vingarzan/vw-touareg-760-867-899-tailgate-clip/README.md

# VW Touareg tailgate clip — 760 867 899

**Latest flat-backed models: [v30 shorter lip and full-height rear supports, both fin layouts](drafts/v30/README.md).** Root `stl/` files remain the older v17 baseline.

Printable reconstruction from photographs and caliper measurements of the original clip.

**Status: v17 moves the small retaining clip 2 mm farther from the peg and extends the mounting base by 4 mm in the same direction. Peg, fin and hook stations are retained. Both versions remain in design coordinates. Physical fit remains untested.**

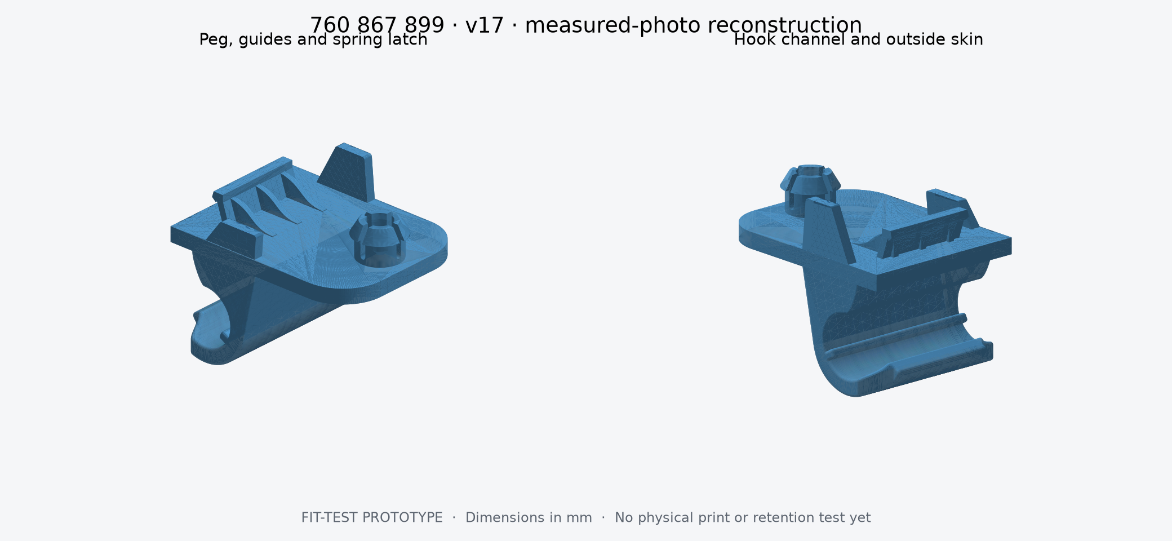
[picture p1: previews/clip.png]
Model preview


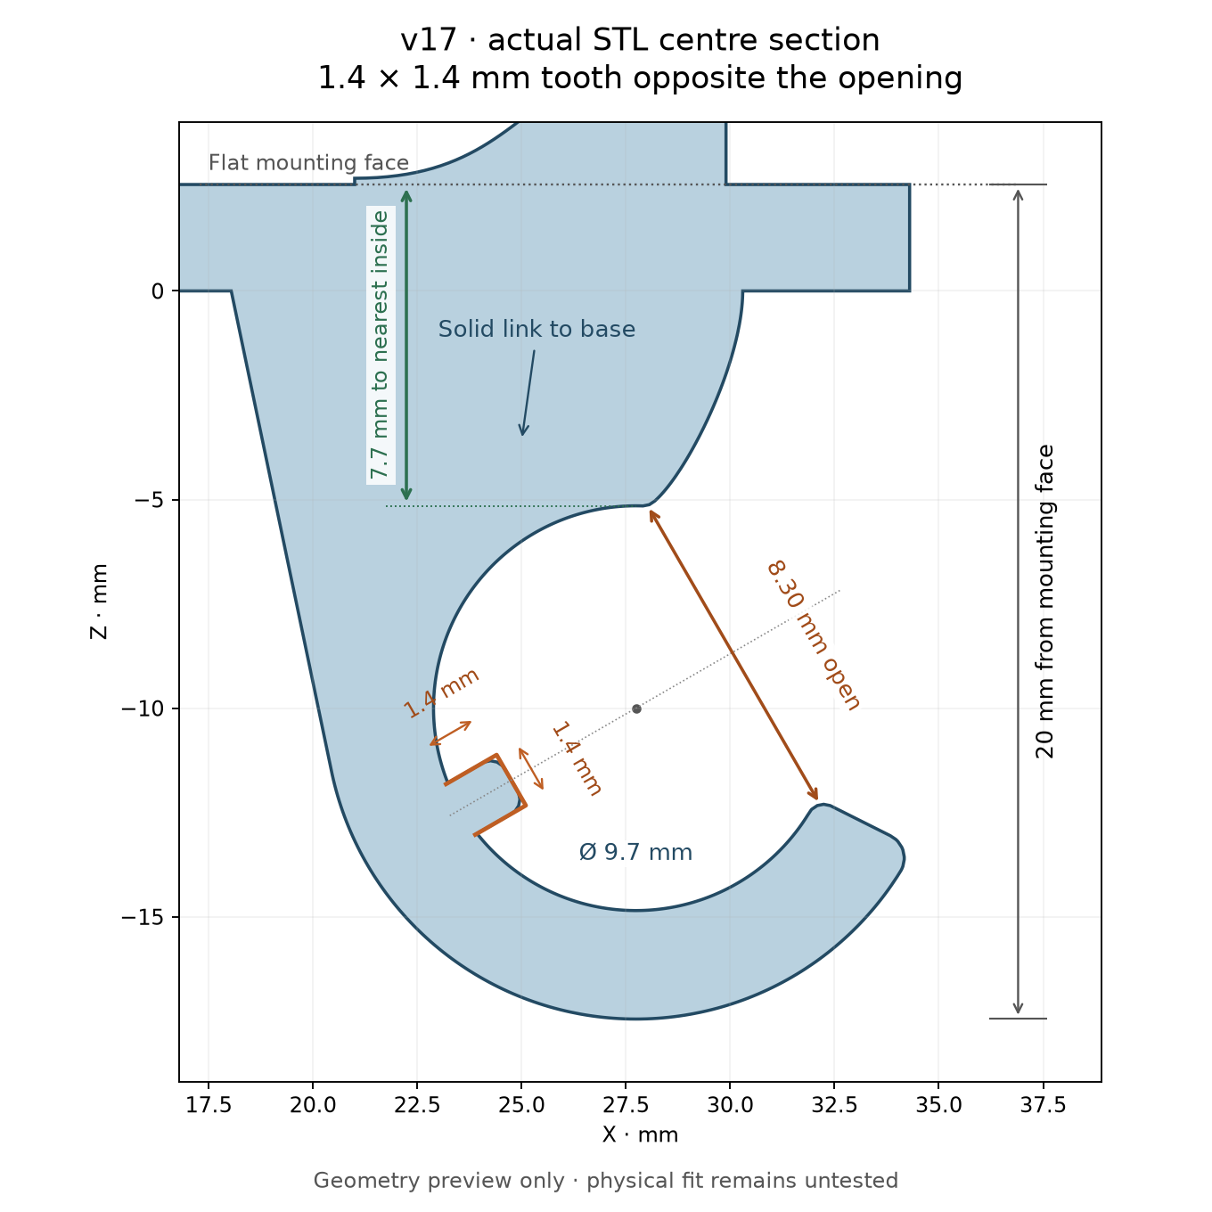
[picture p2: previews/hook_section.png]
Section of the actual STL showing the hook opening and rib


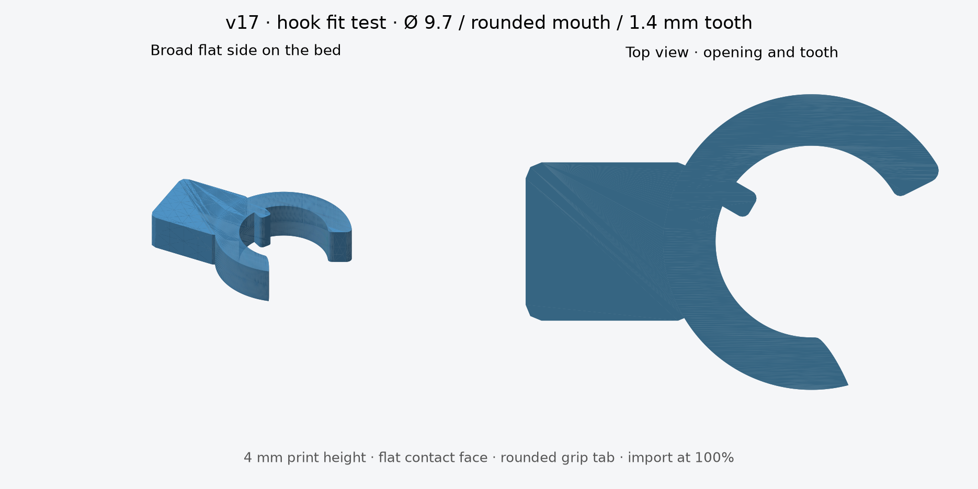
[picture p3: previews/hook_fit_test.png]
Side-printable hook fit test


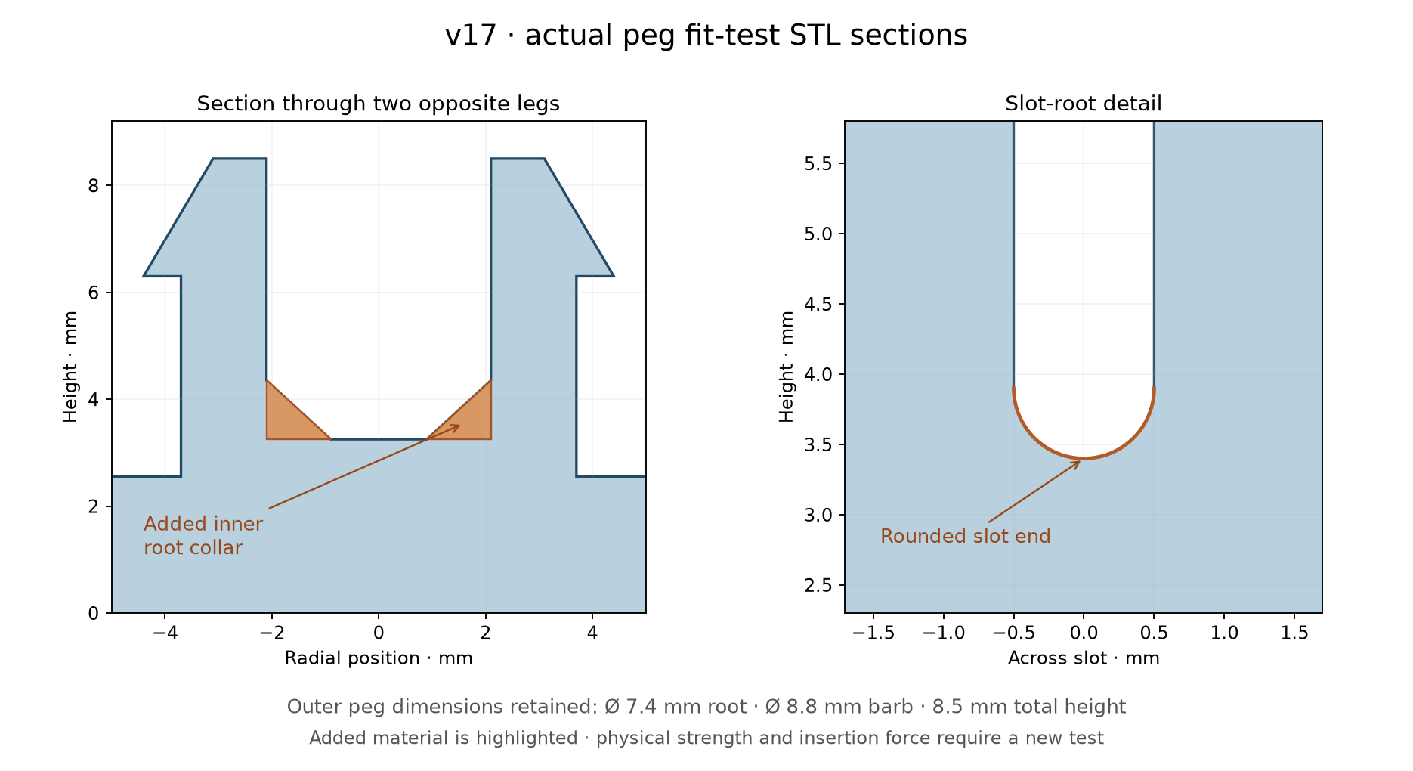
[picture p4: previews/peg_reinforcement.png]
Peg root reinforcement and rounded slot ends


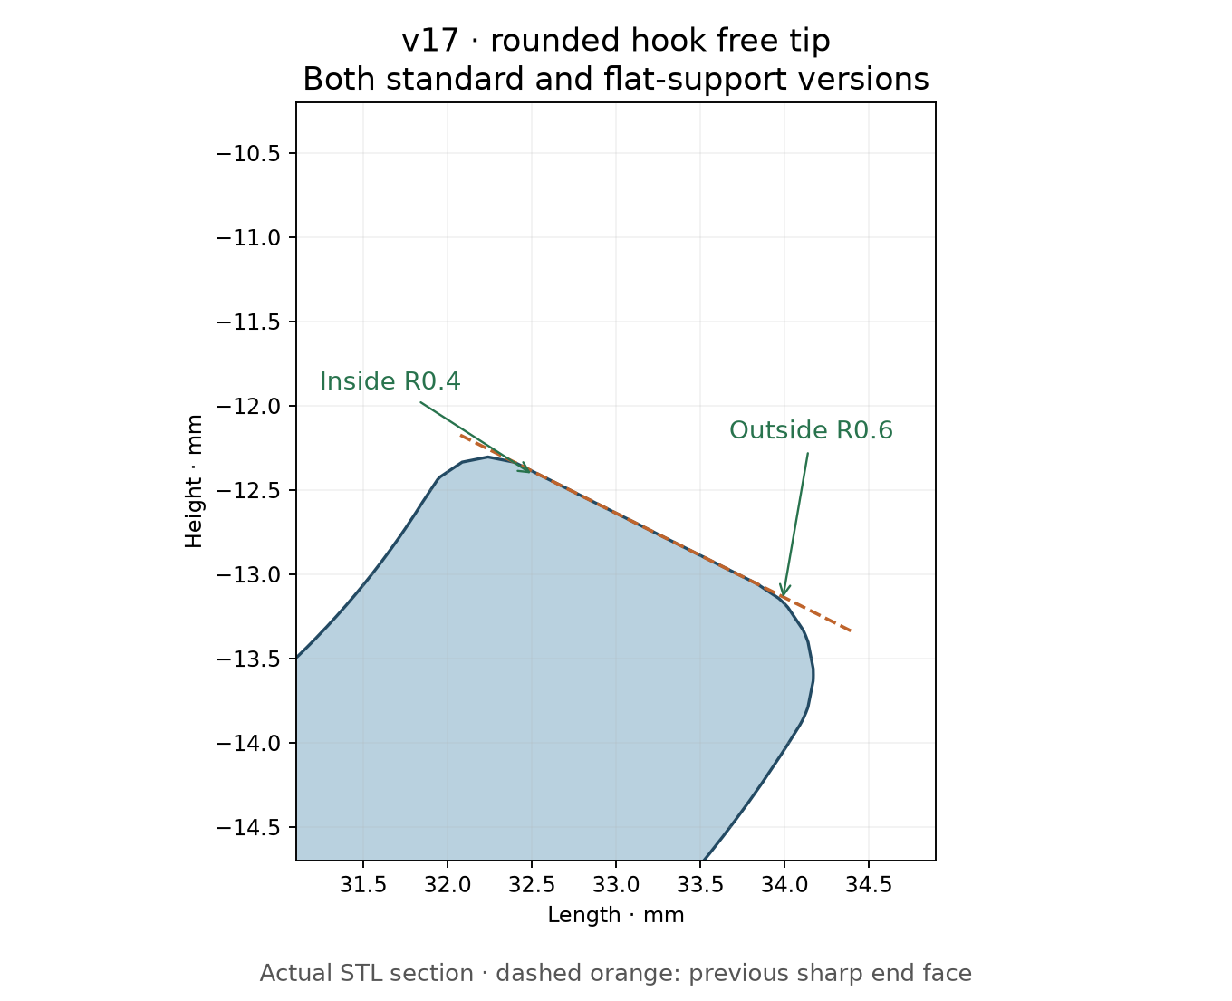
[picture p5: previews/rounded_tip.png]
Rounded free hook tip


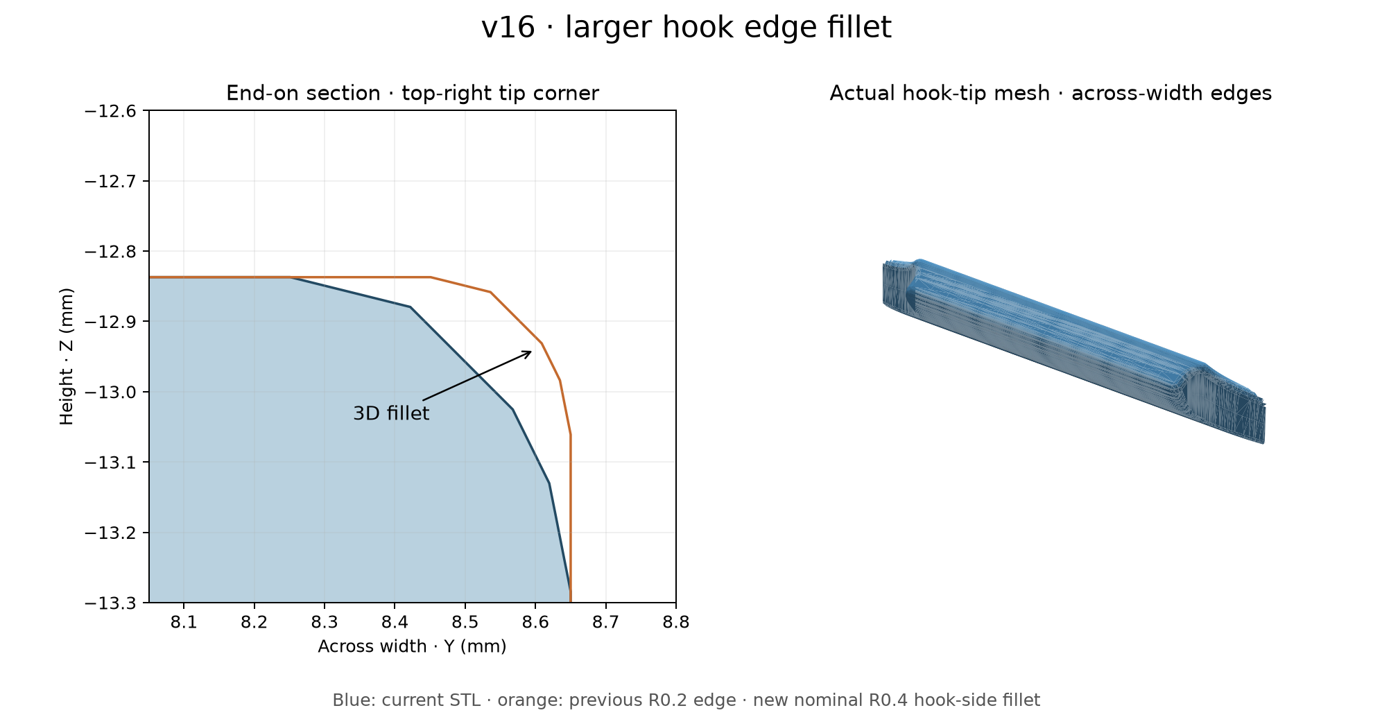
[picture p6: previews/hook_3d_edges.png]
Actual end-on section showing rounding across the width


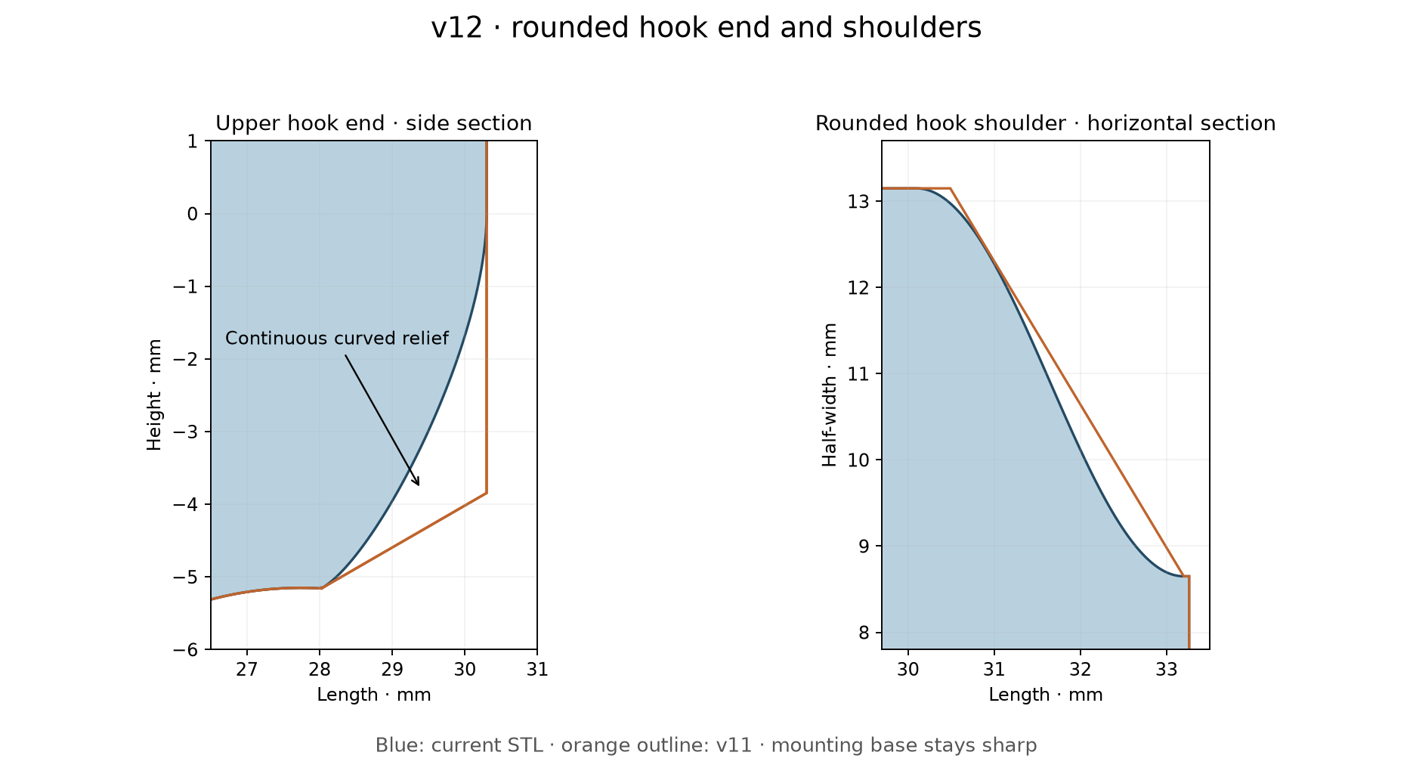
[picture p7: previews/rounded_hook.png]
Rounded hook upper end and shoulders


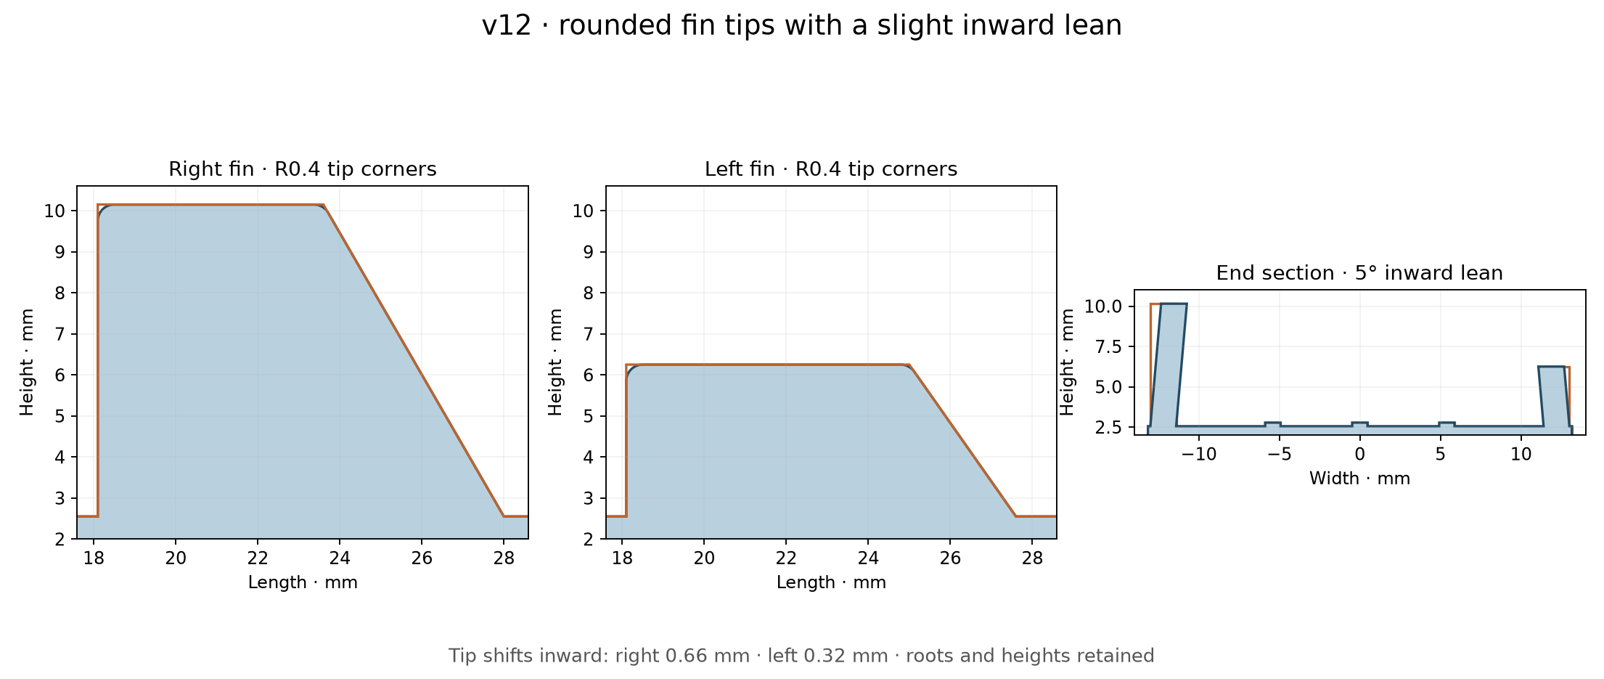
[picture p8: previews/rounded_fins.png]
Rounded fin tips and inward lean


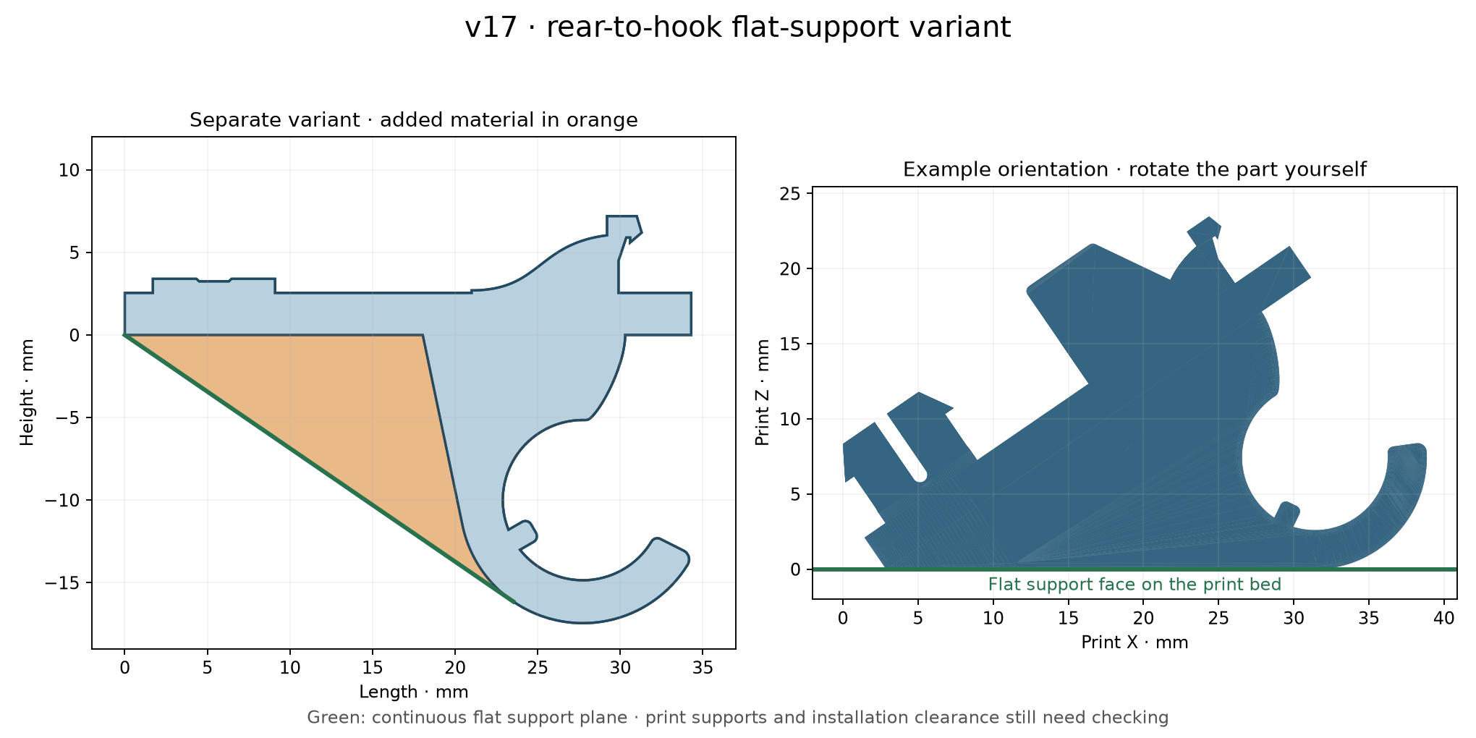
[picture p9: previews/flat_support_profile.png]
Separate flat-support variant and print orientation


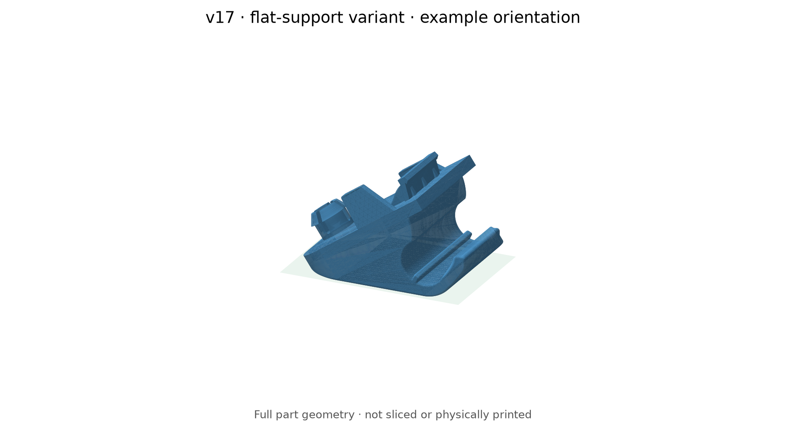
[picture p10: previews/flat_support_print.png]
Example flat-support orientation


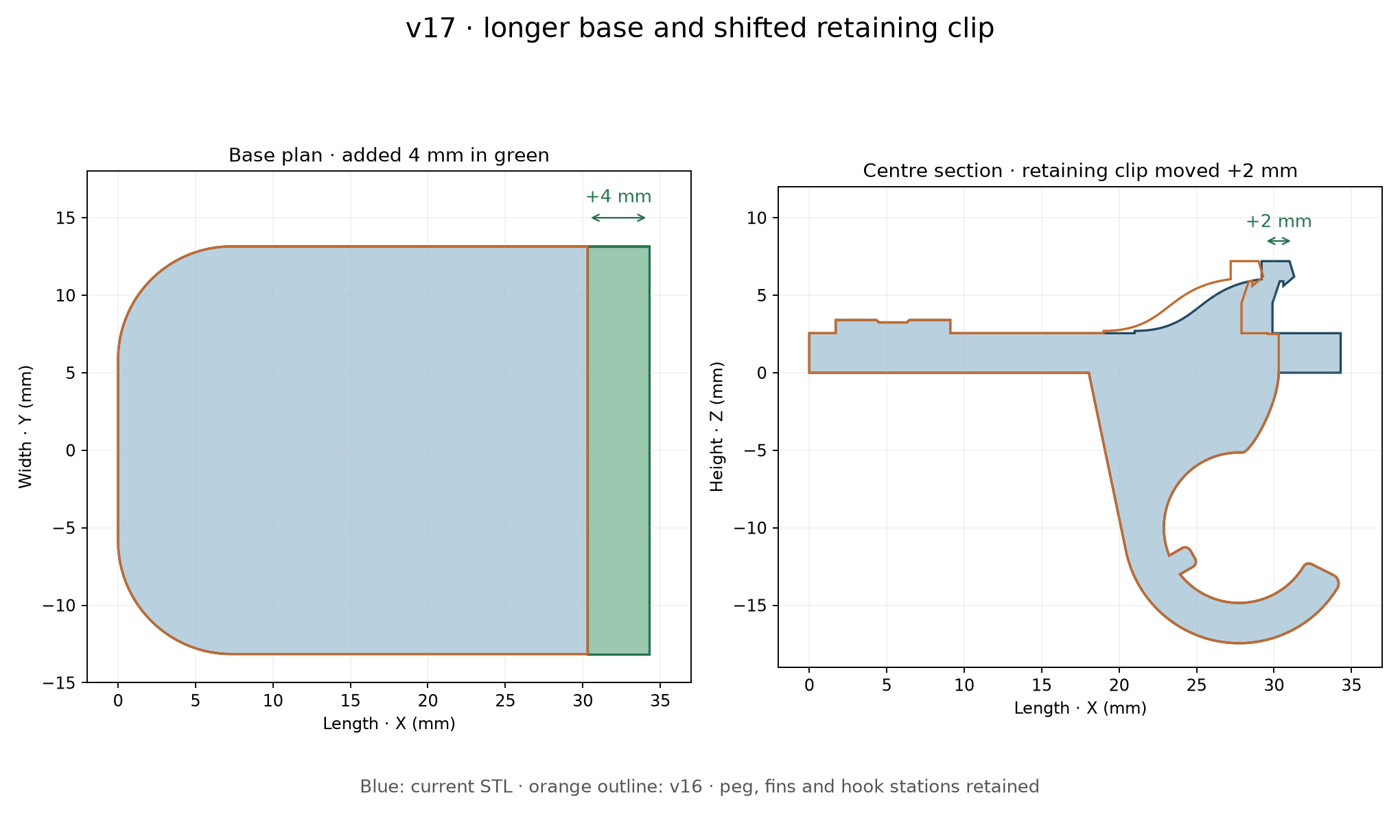
[picture p11: previews/layout_change.png]
Base extension and retaining-clip shift


## STL files

All files use millimetres. Import at 100% scale.

- [`stl/760867899_clip_flat_support.stl`](stl/760867899_clip_flat_support.stl): separate variant with a continuous flat rear support face from the rear underside of the base, tangent to the outside hook curve.
- [`stl/760867899_clip.stl`](stl/760867899_clip.stl): complete clip in design coordinates.
- [`stl/760867899_hook_fit_test.stl`](stl/760867899_hook_fit_test.stl): a compact **side-printable hook gauge** with a rounded grip tab. It has the actual 9.7 mm bore, rounded entrance (about 8.30 mm at the reference throat station) and 1.4 × 1.4 mm tooth, without the bulky mounting body. It is already laid on its broad flat side and is only **4 mm high**. Import at 100%, keep this orientation and print without supports. It checks the mating shape, not full-width stiffness or retention.
- [`stl/760867899_peg_fit_test.stl`](stl/760867899_peg_fit_test.stl): the reinforced split peg on a 14 × 14 mm flat base. Print this updated test with the peg upright to check the new root support and fitting force before printing the complete clip.

The full clips are supplied in design coordinates. Rotate them in your slicer.
The pre-rotated full-part STLs were removed in v14; earlier versions remain in
Git history. The compact hook gauge still uses its natural broad-side orientation.
The complete part has undercuts.
It has not been sliced or printed. Keep support material out of the four peg
slots and the spring latch where possible; inspect and clear those gaps before
attempting a fit. Do not force an undersized hook or oversized peg into the car.

## Validation and rebuilding

The exported STLs were reloaded and checked for a single connected solid,
watertightness, consistent winding, positive volume and no zero-area triangles.
Float32-collapsed triangles are removed before export; valid small-area fillet
triangles are retained. The report records the minimum triangle area.
See [`validation/geometry_checks.json`](validation/geometry_checks.json).
Cross-sections of the exported clip also independently verify the rounded-tip arcs,
minimum nominal opening clearance and actual local entry width,
peg diameters and height, both fins, the 9 mm longitudinal edge gap, lip width
and latch width to 0.003 mm of their design values. The 8.1 mm
sharp-lip throat is a nominal reference; the rounded local entry is approximately 8.30 mm. That is a digital geometry tolerance, not a physical measurement
or printing accuracy claim.
The checks also measure the 20 mm hook drop and the 1.4 × 1.4 mm projecting tooth
at both ends and the centre. Fifty-one rays through the exported STL's entry
path check that the mouth is not blocked by the platform, frame or neck.
Twenty additional sections across the back link verify one continuous material
interval at the former gap, including the centre and both sides.
The hook gauge has separate exported-STL checks: full first-layer contact, a
constant profile through its 4 mm print height, matching mating geometry against
the complete clip, and measured bore, mouth and tooth at three width stations.
The external grip tab does not intrude into the cavity or entry. Its footprint
is approximately 20.92 × 14.75 mm.
Three sections through the front crossbar and the overall model width verify
that its lateral edges are flush with the 26.3 mm base.
Additional exported sections check the flush side width, tangent backing and
lower circular exterior, eight diagonal sections of the peg collar, and ten
points along its rounded slot ends. These are geometry checks, not evidence of
physical strength, printed fit or service life.

The across-width close-up is generated with `python model/render_3d_edges.py old.stl`.

Hook and fin close-ups are generated with `python model/render_rounding.py old.stl`
using an exported previous clip for the orange outline.

The before/after base preview is generated from exported STL sections with
`python model/render_base_sides.py old.stl new.stl preview.png`.

The rebuildable source is provided to preserve the design history even though
only STLs are needed for printing:

```sh
python3 -m venv .venv
.venv/bin/pip install -r model/requirements.txt
.venv/bin/python model/build.py
```

[`model/parameters.json`](model/parameters.json) separates measured dimensions
from estimates. The standard model retains the measured fin root positions and heights and
places their nearest root edges **9 mm beyond the hook-facing edge of the
peg root along the length of the base**. This is an approximate physical
measurement implemented as 9.0 mm in the model.

The back of the hook now joins the mounting base through a **solid full-width
web**, filling the triangular gap left in v05. The original rear slope is kept;
only the hook cavity and entry remain open. This is a geometry change requested
by the owner, rather than a reproduction of the OEM material-saving recess.

The new caliper photo measures **7.7 mm from the peg/fin mounting face to the nearest inside hook curve**, perpendicular to that face. This was 7.8 mm in v09. Preserving the 20 mm outside drop and 9.7 mm bore gives a derived hook wall of **2.6 mm** (20 − 7.7 − 9.7), replacing the estimated 2.5 mm. This is not the distance to the lower free lip.

The separate lateral support webs have been removed. The hook, back link and
neck now stay within the **26.3 mm base width**, with no support projecting
past the base below the mounting plane. The solid back link meets the outer
hook circle at a tangent, eliminating the stepped middle/lower support corners.
In v11 the **front crossbar is also trimmed to 26.3 mm**, removing its remaining
0.65 mm tab on each side. The original 27.6 mm width is retained in the measurement
record as reference; the printable model now has a maximum width of 26.3 mm.

The peg now includes an **internal tapered root collar**. At the cavity floor
(Z=3.25 mm), the inner radius is reduced from 2.1 to 0.9 mm; it tapers back to
2.1 mm over 1.1 mm of height. This adds material inside each leg at its root
while retaining the upper hollow section. The 1 mm-wide slots now terminate in
0.5 mm-radius semicircles, with their lowest cut at Z=3.4 mm instead of the old
sharp Z=3.25 mm corners. Outer diameters and total peg height are retained.
These are new design choices intended to reinforce the roots; insertion force,
flexibility, strength and fatigue must be checked with a fresh physical trial.

The opposite 15 mm-wide latch now joins the base through a continuous wall,
reinforced by three solid gussets on the peg side. Its wall thickness and lean
are photo estimates. The mounting surface beneath peg and fins is flat and
continuous, as requested by the owner; material-saving recesses are omitted.

Looking from the **rounded peg end toward the hook**, with the peg pointing up,
the **right fin is the taller fin** (negative Y). In their side profiles, both
fins retain a straight peg-facing edge below the rounded tip and taper toward
the hook. The upper profile corners now have **R0.4 mm** rounding. The measured
top lengths are kept as the unrounded construction envelope; rounding shortens
the flat part at the very top. Both fins lean **5° inward across the width**,
shifting their ends inward by 0.66 mm (right) and 0.32 mm (left). Root positions,
1.6 mm wall thickness and heights are retained. The fin rounding and lean values are
design choices. Please compare with the original before printing the whole part.

## Flat-support variant

The optional version adds a solid wedge under the base, extending the existing
hook backing to the rounded rear of the base. Its outside face is a single
plane tangent to the hook circle. In the example flat-face-down orientation,
it has approximately **699 mm² of bed contact**, and every vertex is above that
plane. No rotated full-part STL is supplied. This is a
geometry check, not a sliced or printed support-free claim. The peg, fins,
retaining latch and measured hook mating dimensions are retained. The extra
backing adds approximately **3.43 cm³** of material; its installation clearance
needs checking. Both standard and flat-support versions include the v14 rounded
free tip. See [`validation/flat_support_checks.json`](validation/flat_support_checks.json)
for the exported mesh, contact-plane and mating-section checks.

## Reference measurements

| Feature | mm | Evidence |
|---|---:|---|
| Overall length | 34.4 | `reference/measurements/01.jpg` |
| Body width at first measurement position | 26.3 | `reference/measurements/02.jpg` |
| Earlier caliper span; not used as total height | 19.8 | `reference/measurements/03.jpg`; superseded height interpretation |
| Hook inside diameter | 9.7 | Owner correction explicitly confirmed as diameter; supersedes the initial 9.4 mm reading in photo 08 |
| Mounting face to nearest inside hook curve | 7.7 | `reference/measurements/20.jpg`; perpendicular to mounting face |
| Hook mouth, narrower entrance | about 8–8.2; model 8.1 | `reference/measurements/09.jpg` and owner clarification |
| Mounting face down to farthest outside hook edge, perpendicular | 20 | Owner measurement and explicit direction clarification |
| Internal tooth local height / inward projection | 1.4 / 1.4 | Owner corrected the earlier 2.4 mm values and specified placement opposite the opening |
| Narrow hook lip width | 17.3 | `reference/measurements/10.jpg`; read from jaw placement |
| Original maximum frame width; trimmed to 26.3 in v11 | 27.6 | `reference/measurements/11.jpg` |
| Outside guide width | 26.0 | `reference/measurements/12.jpg` and owner clarification |
| Base wall | 2.5–2.6 | Owner measurement; design uses midpoint 2.55 |
| Peg total height, including base wall | 8.5 | Owner measurement |
| Peg widest diameter / base diameter | 8.8 / 7.4 | Owner measurement |
| Spring latch width | 15.0 | Owner measurement |
| Right fin: base / top length | 9.9 / 5.5 | Owner measurement |
| Right fin: height above inner surface | 7.6 | Owner measurement and explicit height clarification |
| Left fin: base / top length | 9.5 / 6.9 | Owner measurement |
| Left fin: height above inner surface | 3.7 | Owner measurement |
| Both fin walls | 1.6 | Owner measurement |
| Peg root to nearest fin edges, along base length | about 9 | Owner measurement; edge-to-edge direction explicitly confirmed |

The peg position, hollow centre and slits, latch positions, flexure thicknesses,
and small radii are photo estimates. Photographs do not provide a calibrated 3D scan.

The mounting face is Z=2.55 mm. The corrected hook drop puts its lowest outside
edge at Z=-17.45 mm. The right fin reaches Z=10.15 mm, making the complete model
**approximately 34.3 × 26.3 × 27.6 mm** in v17: the extended base now determines
the overall length. The 34.4 mm OEM sharp-tip envelope is retained as a historical
reference for locating the hook; the hook itself was not moved. v01–v03 incorrectly treated the earlier 19.8 mm caliper
span as the entire part height; v04 supersedes that interpretation.

The hook/support body now receives a **nominal R0.4 mm 3D fillet** on its
exposed convex edges, including the across-width edges that remained sharp in
v14. This uses a tessellated rolling-ball edge treatment. The mounting plate
at and above its underside plane, plus the peg, fins and retaining clip, are
restored unchanged; no extra fillets are applied to those features.
An end-on exported-STL section verifies relief on both lateral tip corners.
v16 doubles the 3D edge radius from 0.2 to 0.4 mm and increases the inner
free-tip radius from 0.25 to 0.4 mm. The outer tip remains R0.6 mm.
The extra edge treatment increases the local reference-station opening to
approximately 8.30 mm. The 9.7 mm bore and mounting datums remain unchanged.
The above-plate geometry in v16 was compared against v15;
see [`validation/v16_preserved_features.json`](validation/v16_preserved_features.json).

The free hook tip has tangent **R0.6 mm outside** and **R0.4 mm inside** corners,
removing both sharp cap edges. Rounding shortens the overall sharp-tip envelope
by about 0.23 mm and widens the local entrance from the 8.1 mm reference to about
8.20 mm. The 9.7 mm bore, tooth and mounting distances are retained.

The hook upper end now uses a smooth curved relief in place of the former
angled flat face. Its lateral shoulders use a smooth taper rather than straight
diagonal cuts. In v12, the mounting base, peg and retaining latch were compared with v11
and have zero geometric difference in their checked regions; see
[`validation/v12_preserved_features.json`](validation/v12_preserved_features.json).
The updated hook gauge reproduces the new central upper-end profile.

The mouth points diagonally outward, as shown in the new side photo, rather
than upward into the mounting platform. Its direction is estimated at 30°
above the base's length axis. The 9.7 mm circular cavity and an 8.1 mm-wide
entry corridor are cleared from the plate/frame/neck geometry; the C-shaped
hook supplies the mating surface. The upper fixed arm stays attached to the
mounting platform, while the entry remains open.

The internal feature is a solid transverse **rib**, not a recessed groove.
It projects 1.4 mm radially inward from the nominal inner wall and measures
1.4 mm along the local tangent of the bore. Its centreline is diametrically
opposite the mouth centreline, as specified by the owner, and it runs across
the part width. The section preview shows the shared diameter as a dotted line.
Its small edge radii remain estimates. The hook's 2.6 mm radial shell thickness
is derived from the 20 mm outside drop, 7.7 mm nearest-inside distance and
9.7 mm bore. The mounting base independently uses 2.55 mm thickness.

The peg centre remains an estimate at X=5.4 mm from the rounded end. Its root
ends at X=9.1 mm; the fins start at X=18.1 mm. The flat platform extends to
X=34.3 mm in v17, compared with the v16 base/crossbar end at X=30.3 mm.
This is a **4 mm increase in actual mounting-base length**. The small retaining
clip, its wall and all three ribs are translated **2 mm along +X**, away from
the peg. The 15 mm clip width and its shape are retained; the peg, fins and hook
locations are unchanged. See [`validation/v17_layout_checks.json`](validation/v17_layout_checks.json).
Only the relative peg-to-fin station has now been measured. The latch station,
its approximately 1.2 mm-thick support wall and the front frame position remain
photo estimates and should be compared with the original before printing.

## First print

1. Print the hook and peg fit-test pieces at 100% scale. The peg piece sits flat
   with the peg upright. Keep the hook gauge on its broad flat side as supplied:
   it is 4 mm high with approximately 130 mm² of bed contact. No supports are
   needed for its constant profile. Use the rounded external tab to hold it.
   The complete clip still requires separate inspection of support placement.
2. Compare the full clip preview with the original, especially the tall-fin side.
3. Inspect support placement and layer paths for the full clip. The side STL is
   an orientation option, not a validated print profile. Its small contact area
   may need a brim, and its horizontal peg and fins may need support.
4. Check fit gently, then inspect for cracking and adequate retention before
   using it to hold tailgate trim. A fit-test pass does not establish service life.

Printer, material, shrinkage, temperature resistance and spring fatigue have not
been validated. No material-specific printer settings are supplied.

## Revision policy

Commit every model revision with its STL files, source parameters, preview, checks,
and change notes. Keep stable filenames for the current files; Git history retains
all prior revisions. Do not squash or overwrite the design history.

## Photographs

- `reference/measurements/`: twenty owner-provided JPEG references, in received
  order, published with the owner's explicit permission. Camera metadata was
  removed before inclusion. Photos 13 and 14 show the same measurement view;
  photos 15–18 show the latch wall and its reinforcement in close-up; photo 19
  shows the hook's open side profile and projecting internal rib; photo 20
  records the 7.7 mm base-to-nearest-inside measurement used in v10.
- `reference/listing/source.txt`: the public product listing and original photo
  links, for provenance only. The seller's photographs are **not redistributed**
  in this repository, including in its published Git history.

VW and Touareg identify the part reference only. This project is not an OEM CAD
release or a certified replacement.
