vingarzan/vw-touareg-760-867-899-tailgate-clip/drafts/v19/README.md

# v19 fast draft — fin roots moved inward

Millimetres; import at 100% scale. Fin root outside-to-outside span is 24.5 mm, reduced from 26.0 mm. This moves each fin 0.75 mm inward. The explicit 24.5 mm measurement is used in preference to the approximate 0.5 mm movement request. Clear inside gap is approximately 21.3 mm with the retained 1.6 mm walls.

Includes the measured taper profiles, longer base, +2 mm retaining-clip shift, swept support and shallow rounded-profile recesses. Expensive final 3D support fillets and recess-floor rounding remain omitted from this draft. The fin heights, tip shape and inward lean are unchanged.

The exported STL is watertight, consistently wound and has positive volume. Physical fit and full dimensional validation are not established. Generate with build(edge_round=False, quick_draft=True). The main published model remains v17 pending completion of these draft revisions.

The flat-backed version is also available as stl/760867899_clip_flat_support.stl, in design coordinates. It uses the same latest tapered profiles and 24.5 mm fin root span. Its continuous rear-to-hook flat backing is retained. Basic mesh checks pass; the same unfinished edge-treatment caveat applies. Generate with build(flat_support=True, edge_round=False, quick_draft=True).
