vingarzan/vw-touareg-760-867-899-tailgate-clip/drafts/v18/README.md

# v18 work-in-progress draft

Exported at the owner’s request before final edge treatment. This STL includes the approved measured tapers, 34.3 mm base, +2 mm retaining-clip shift, revised swept support, and shallow rounded-profile side recesses. The final 3D edge fillets and recess-floor fillets are omitted.

Millimetres; import at 100% scale and choose orientation yourself. Basic reload checks confirm watertightness, consistent winding and positive volume. Full dimensional validation, physical fit and printing are not established.

The model folder is a snapshot of the working source. Generate this draft with build(edge_round=False, quick_draft=True), rather than the unfinished full-fillet build. The main published model remains v17 until v18 is completed.
