vingarzan/vw-touareg-760-867-899-tailgate-clip/previews/flush_base_sides.png

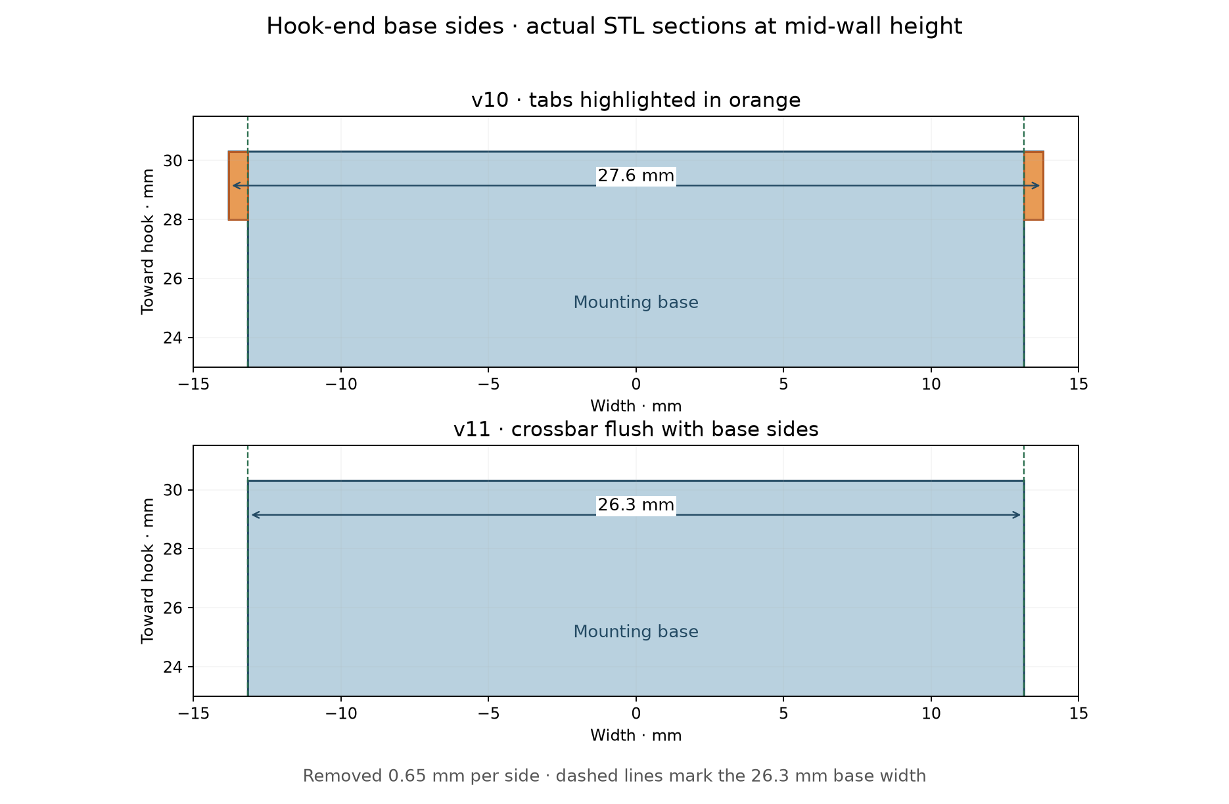
previews/flush_base_sides.png
