vingarzan/vw-touareg-760-867-899-tailgate-clip/previews/orthographic.png

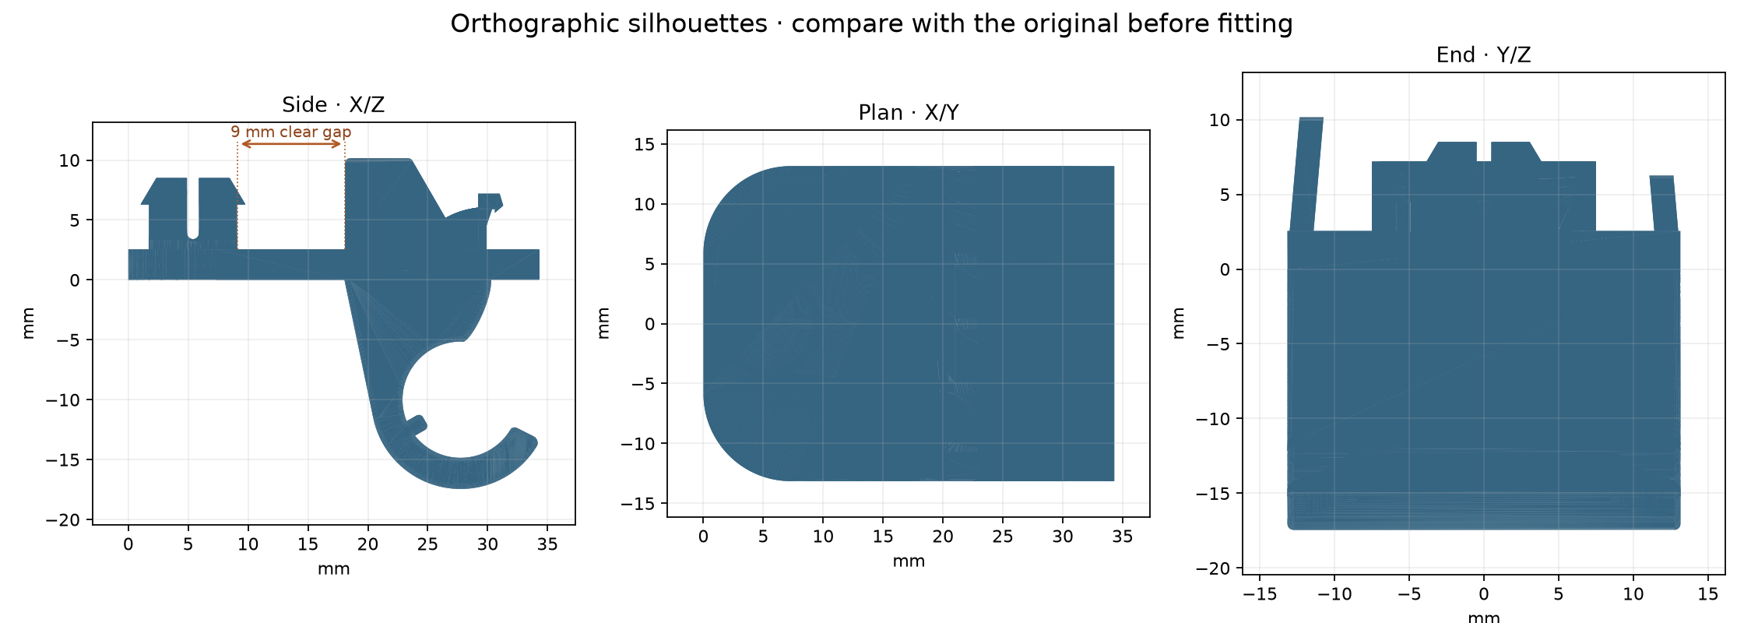
previews/orthographic.png
