vingarzan/vw-touareg-760-867-899-tailgate-clip/drafts/v30/stl/760867899_v30_existing_flat_support.stl

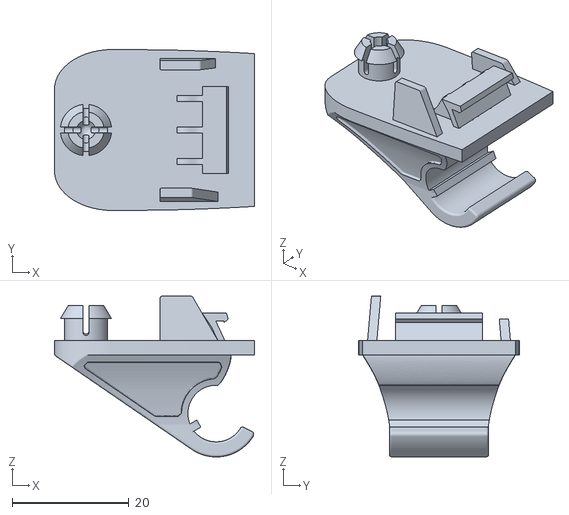
[picture p25: CAD file, 2026-10-24]
drafts/v30/stl/760867899_v30_existing_flat_support.stl
34.3 x 27.6 x 27.6
