vingarzan/vw-touareg-760-867-899-tailgate-clip/stl/760867899_clip.stl

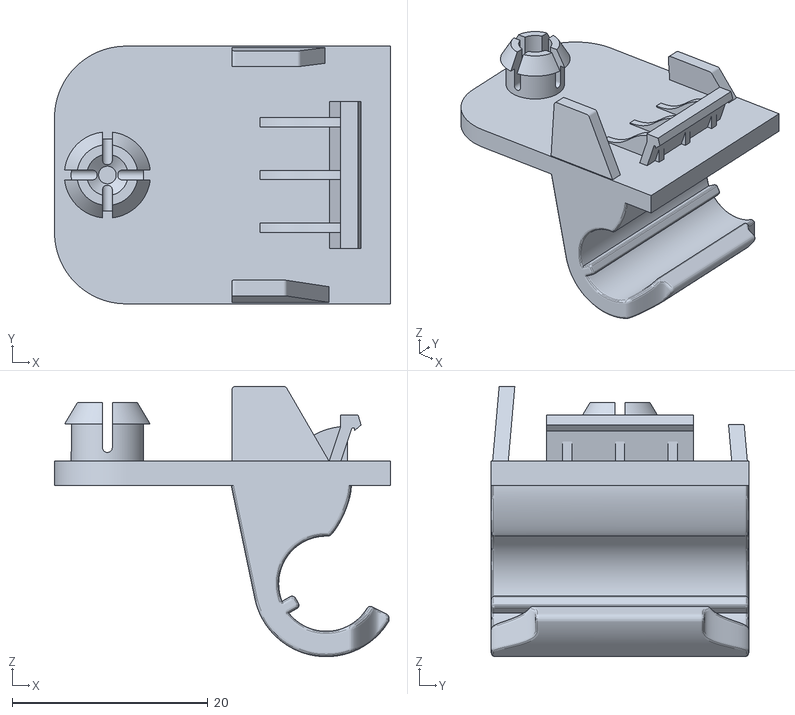
[picture p26: CAD file, 2026-10-24]
stl/760867899_clip.stl
34.3 x 26.3 x 27.6
