vingarzan/vw-touareg-760-867-899-tailgate-clip/stl/760867899_hook_fit_test.stl

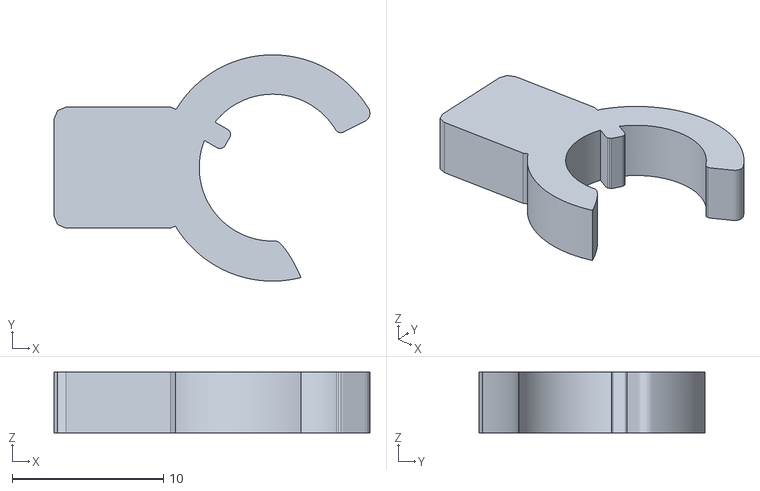
[picture p27: CAD file, 2026-10-24]
stl/760867899_hook_fit_test.stl
20.9 x 14.9 x 4.00
