vingarzan/vw-touareg-760-867-899-tailgate-clip/stl/760867899_clip_flat_support.stl

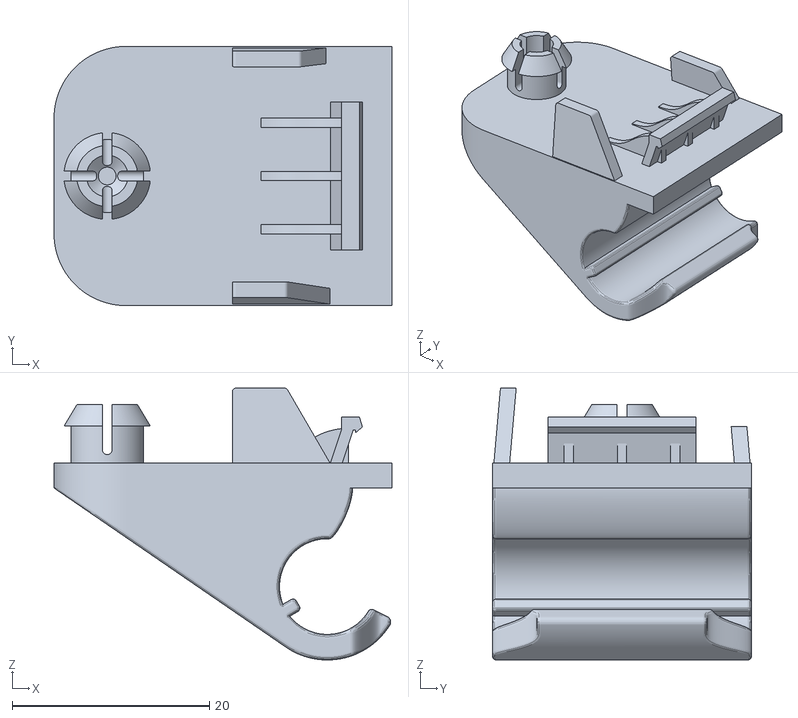
[picture p28: CAD file, 2026-10-24]
stl/760867899_clip_flat_support.stl
34.3 x 26.3 x 27.6
