vingarzan/vw-touareg-760-867-899-tailgate-clip/stl/760867899_clip_on_flat_support.stl

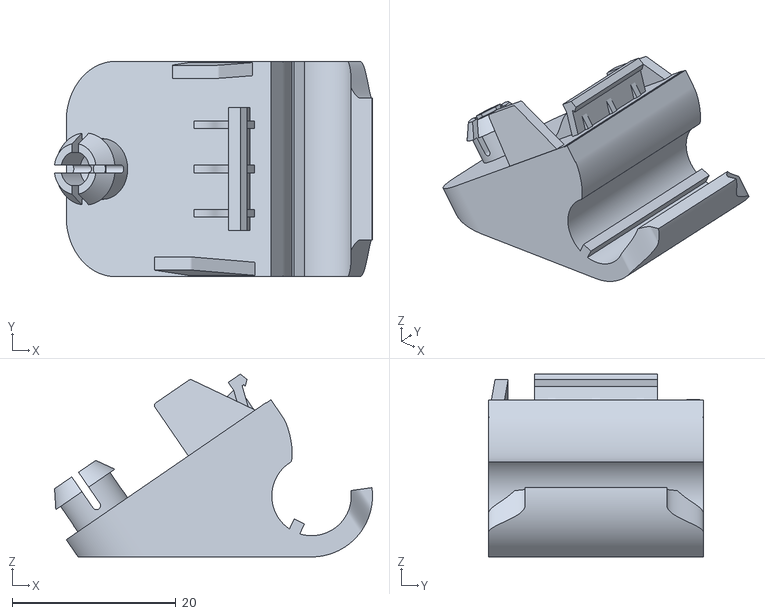
[picture p29: CAD file, 2026-10-24]
stl/760867899_clip_on_flat_support.stl
38.9 x 26.3 x 22.3
