vingarzan/vw-touareg-760-867-899-tailgate-clip/stl/760867899_clip_on_side.stl

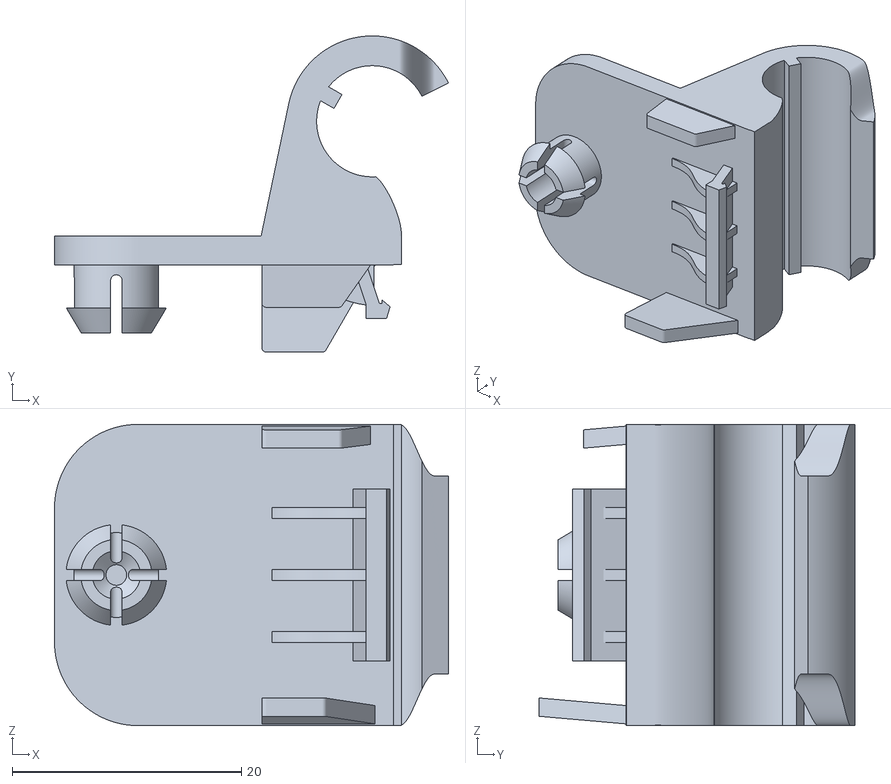
[picture p30: CAD file, 2026-10-24]
stl/760867899_clip_on_side.stl
34.4 x 27.6 x 26.3
