vingarzan/vw-touareg-760-867-899-tailgate-clip/stl/760867899_peg_fit_test.stl

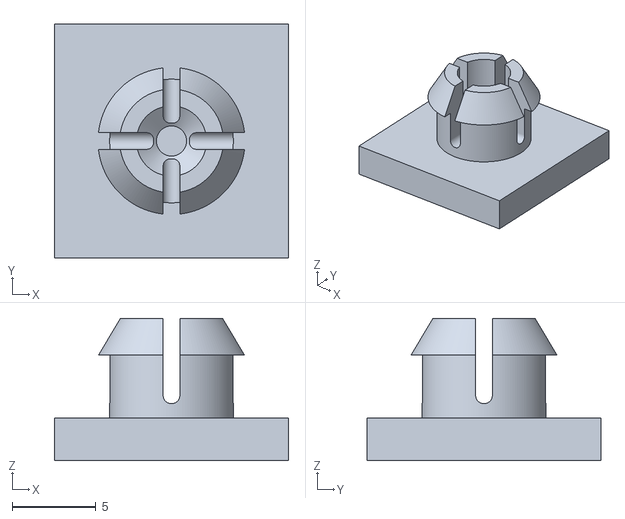
[picture p31: CAD file, 2026-10-24]
stl/760867899_peg_fit_test.stl
14.0 x 14.0 x 8.50
