vingarzan/vw-touareg-760-867-899-tailgate-clip/drafts/v18/stl/760867899_clip.stl

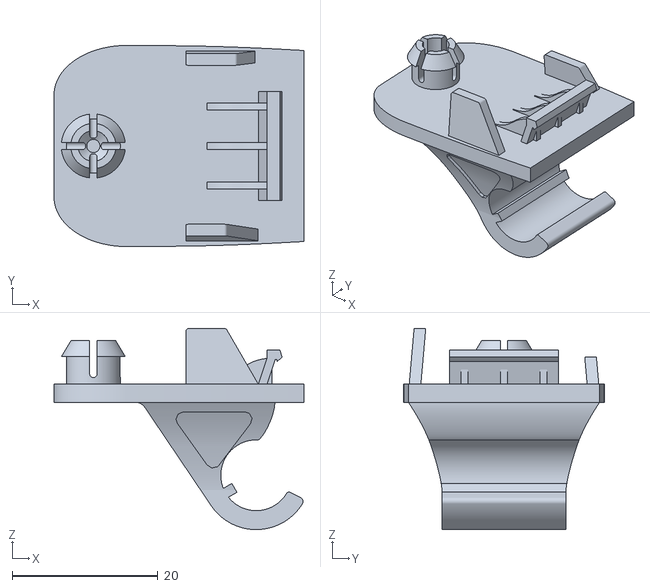
[picture p32: CAD file, 2026-10-24, an earlier design]
drafts/v18/stl/760867899_clip.stl
34.3 x 27.6 x 27.6
