vingarzan/vw-touareg-760-867-899-tailgate-clip/drafts/v19/stl/760867899_clip_flat_support.stl

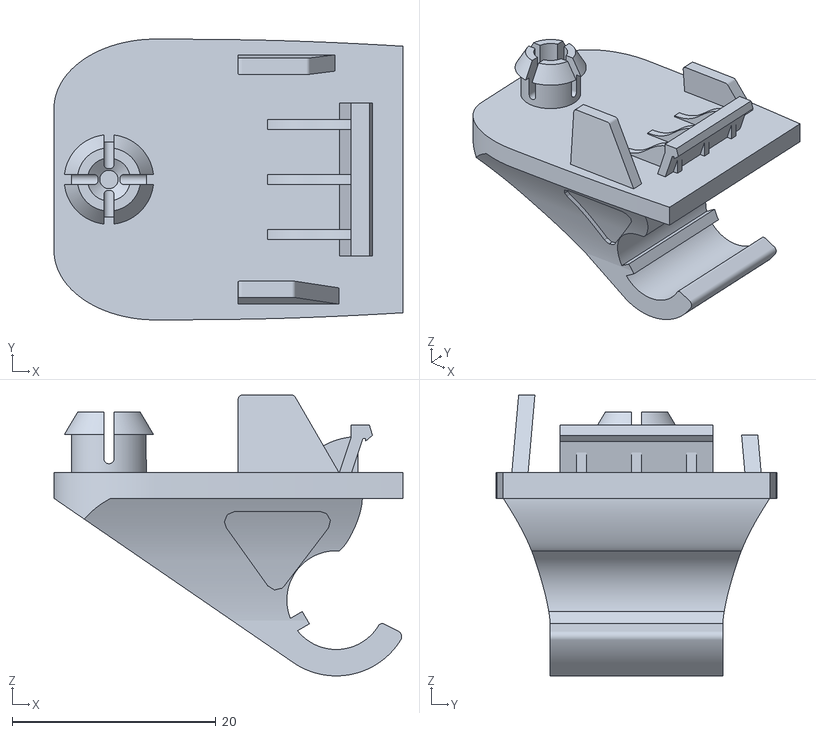
[picture p33: CAD file, 2026-10-24, an earlier design]
drafts/v19/stl/760867899_clip_flat_support.stl
34.3 x 27.6 x 27.6
