vingarzan/vw-touareg-760-867-899-tailgate-clip/(list of files, cad)

Other CAD files:
drafts/v30/stl/760867899_v30_right_flat_support.stl
drafts/v20/stl/760867899_clip_flat_support.stl
drafts/v21/stl/760867899_v21_flat_support.stl
drafts/v23/stl/760867899_v23_right_flat_support.stl
drafts/v24/stl/760867899_v24_right_flat_support.stl
drafts/v25/stl/760867899_v25_existing_flat_support.stl
drafts/v26/stl/760867899_v26_existing_flat_support.stl
drafts/v27/stl/760867899_v27_right_flat_support.stl
drafts/v28/stl/760867899_v28_existing_flat_support.stl
drafts/v19/stl/760867899_clip.stl
drafts/v20/stl/760867899_clip.stl
drafts/v23/stl/760867899_v23_existing_flat_support.stl
drafts/v24/stl/760867899_v24_existing_flat_support.stl
drafts/v25/stl/760867899_v25_right_flat_support.stl
drafts/v26/stl/760867899_v26_right_flat_support.stl
drafts/v27/stl/760867899_v27_existing_flat_support.stl
drafts/v28/stl/760867899_v28_right_flat_support.stl
drafts/v29/stl/760867899_v29_existing_flat_support.stl
drafts/v29/stl/760867899_v29_right_flat_support.stl
