vingarzan/vw-touareg-760-867-899-tailgate-clip/reference/measurements/01.jpg

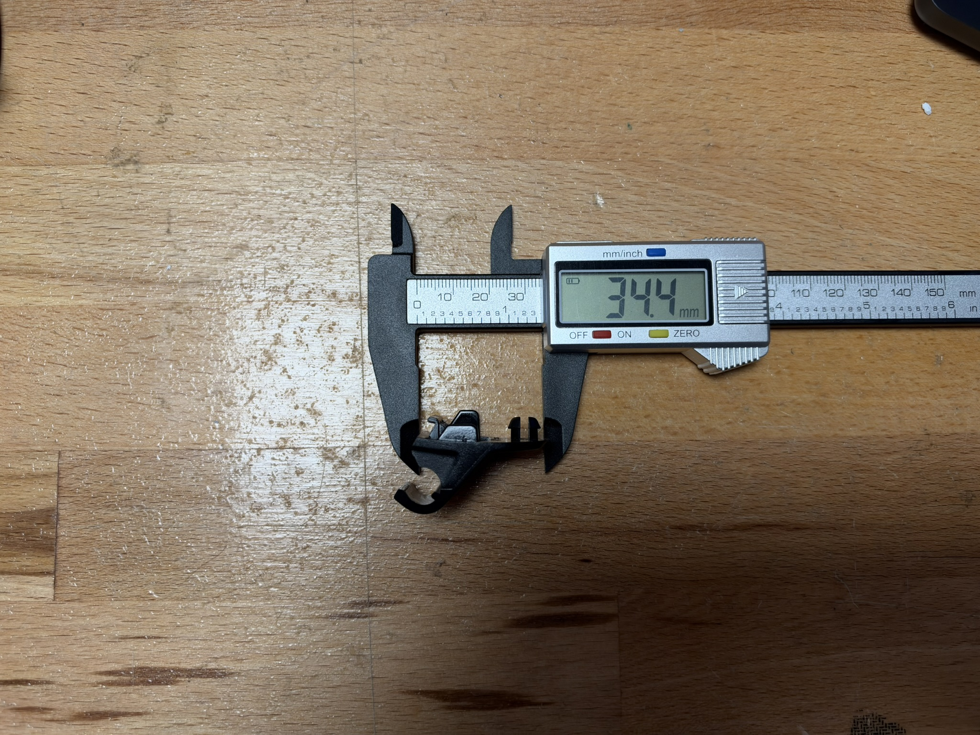
reference/measurements/01.jpg
