vingarzan/vw-touareg-760-867-899-tailgate-clip/reference/measurements/02.jpg

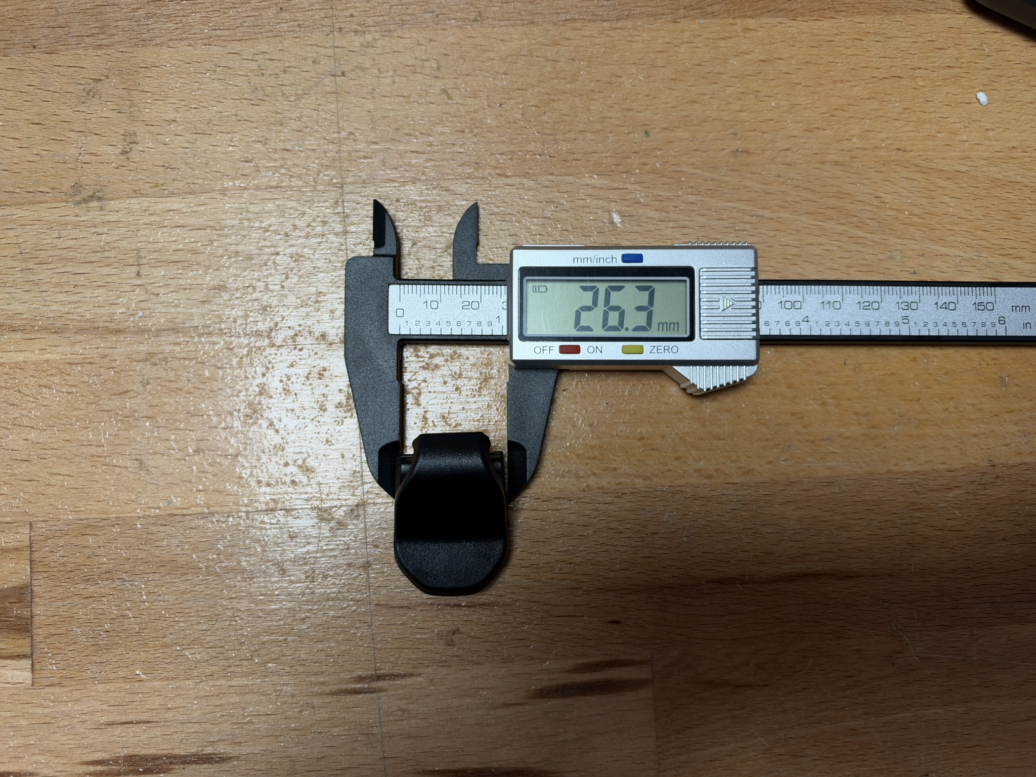
reference/measurements/02.jpg
