vingarzan/vw-touareg-760-867-899-tailgate-clip/reference/measurements/03.jpg

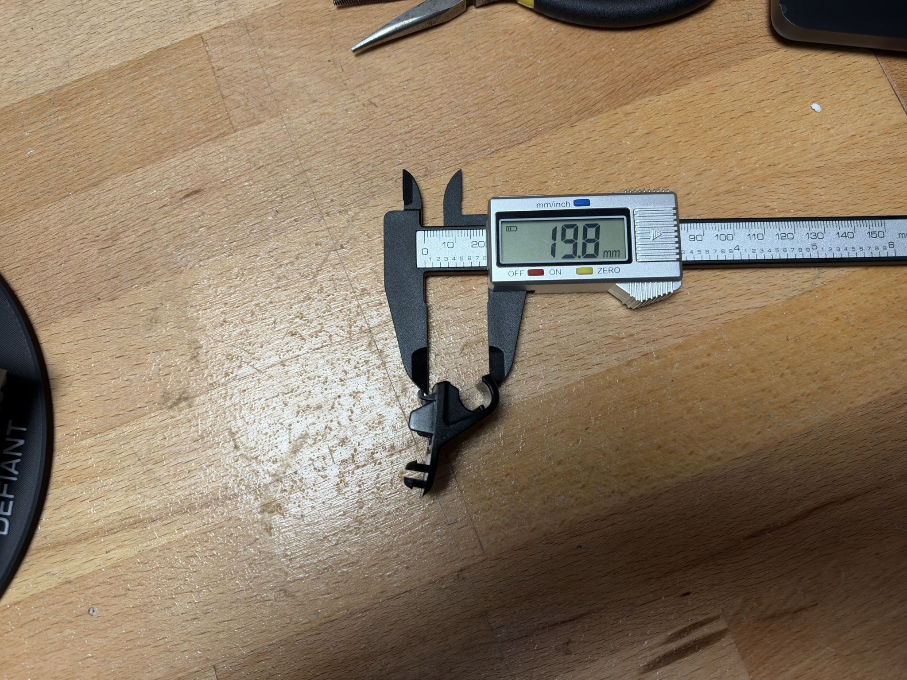
reference/measurements/03.jpg
