vingarzan/vw-touareg-760-867-899-tailgate-clip/reference/measurements/04.jpg

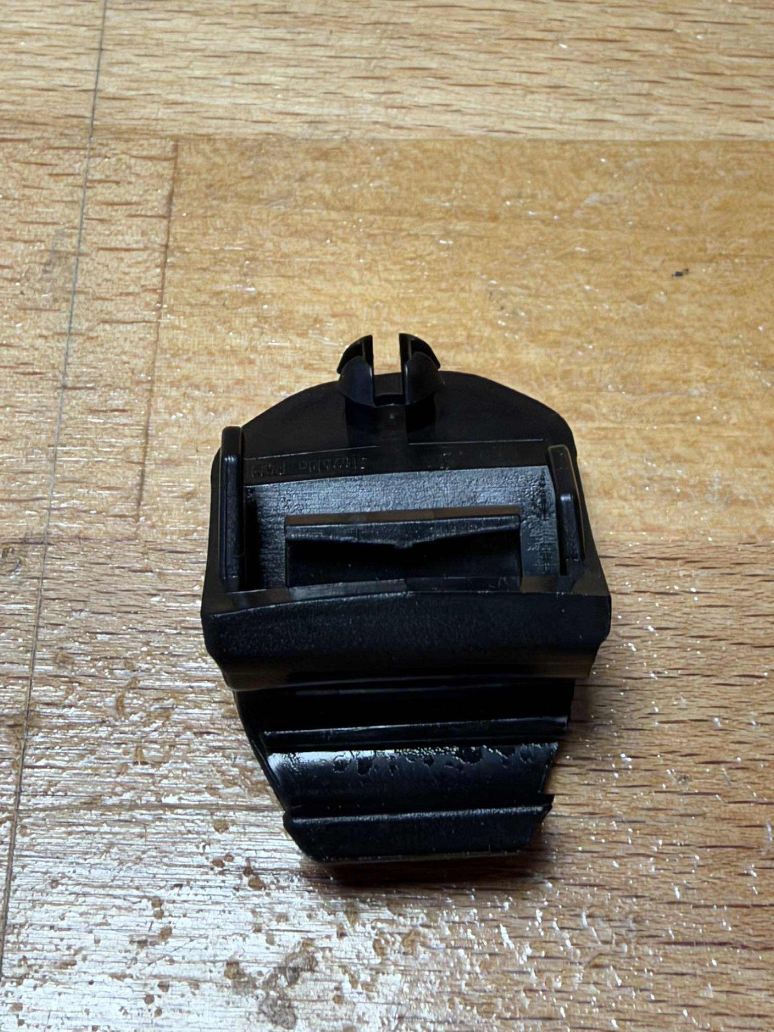
reference/measurements/04.jpg
