vingarzan/vw-touareg-760-867-899-tailgate-clip/reference/measurements/05.jpg

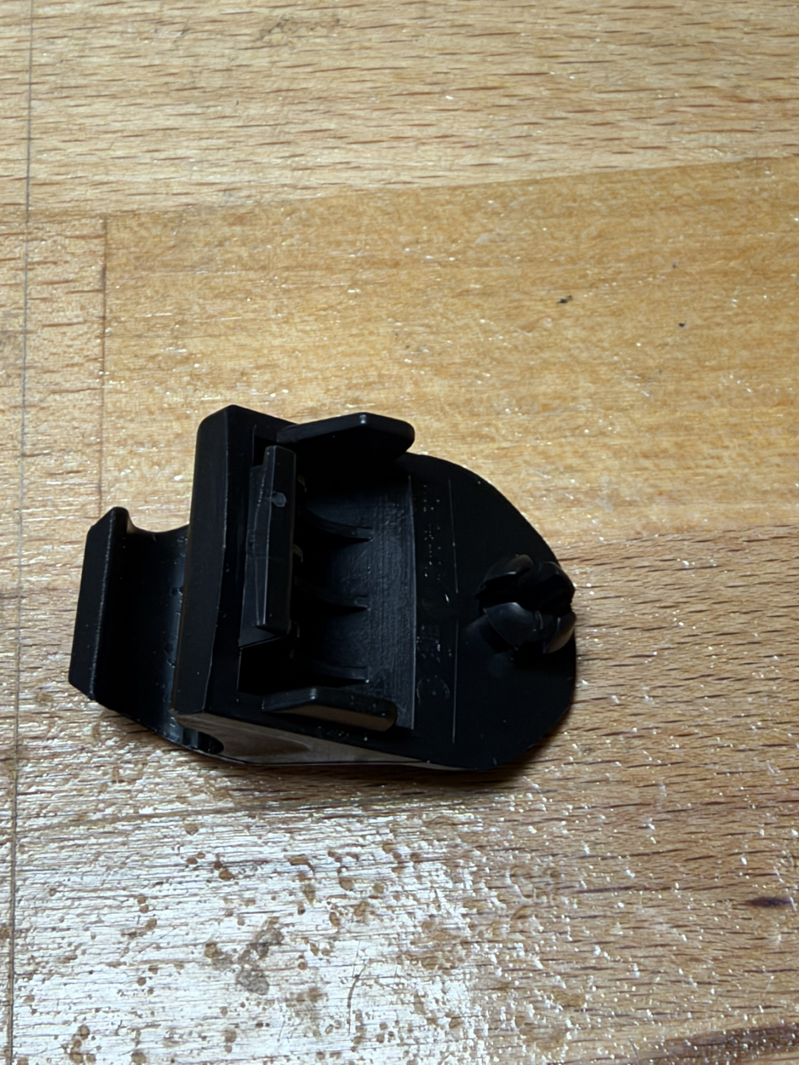
reference/measurements/05.jpg
