vingarzan/vw-touareg-760-867-899-tailgate-clip/reference/measurements/06.jpg

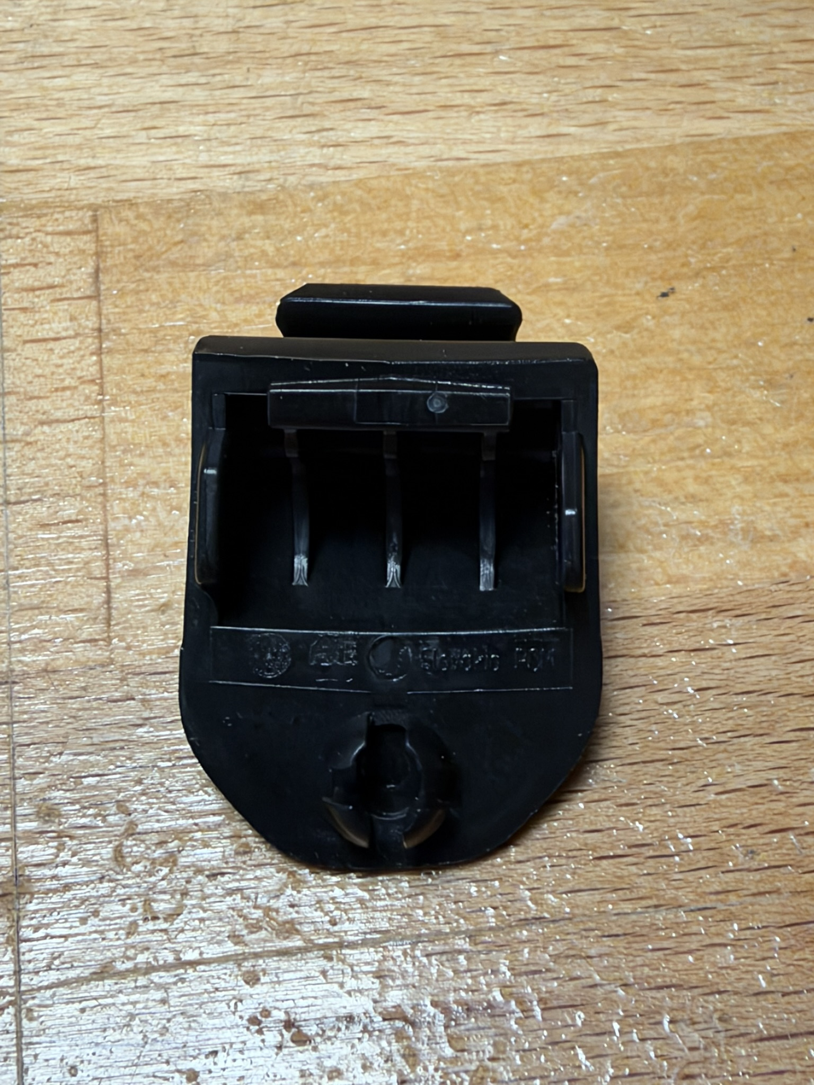
reference/measurements/06.jpg
