vingarzan/vw-touareg-760-867-899-tailgate-clip/reference/measurements/07.jpg

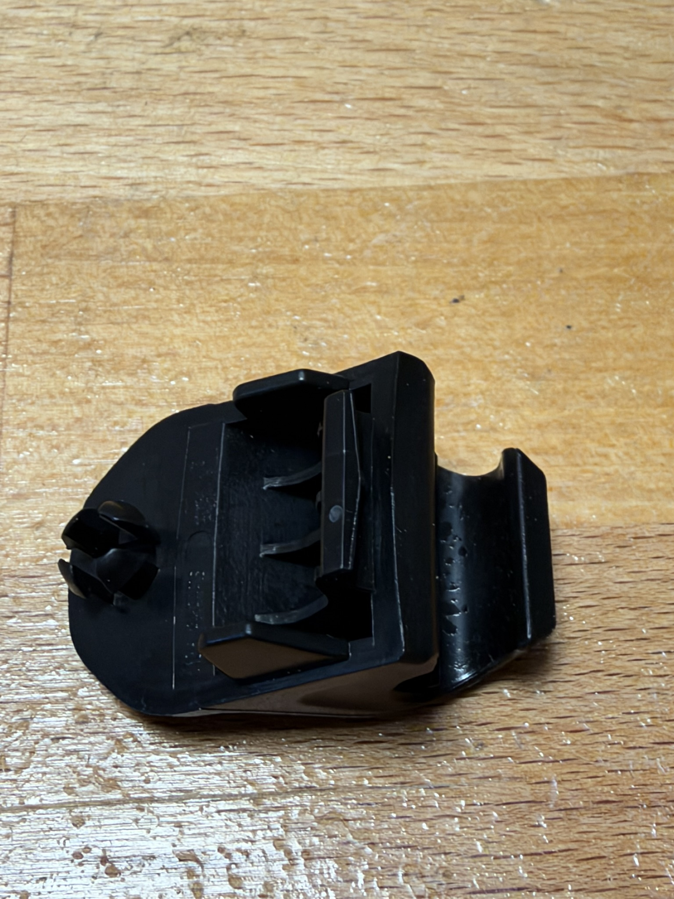
reference/measurements/07.jpg
