vingarzan/vw-touareg-760-867-899-tailgate-clip/reference/measurements/08.jpg

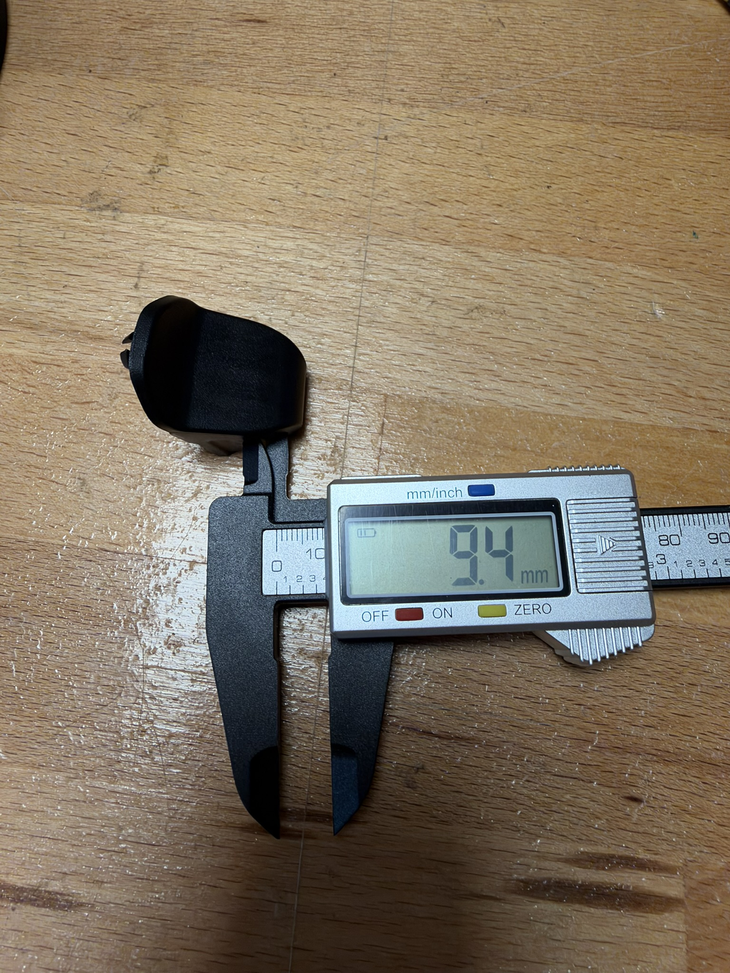
reference/measurements/08.jpg
