vingarzan/vw-touareg-760-867-899-tailgate-clip/reference/measurements/09.jpg

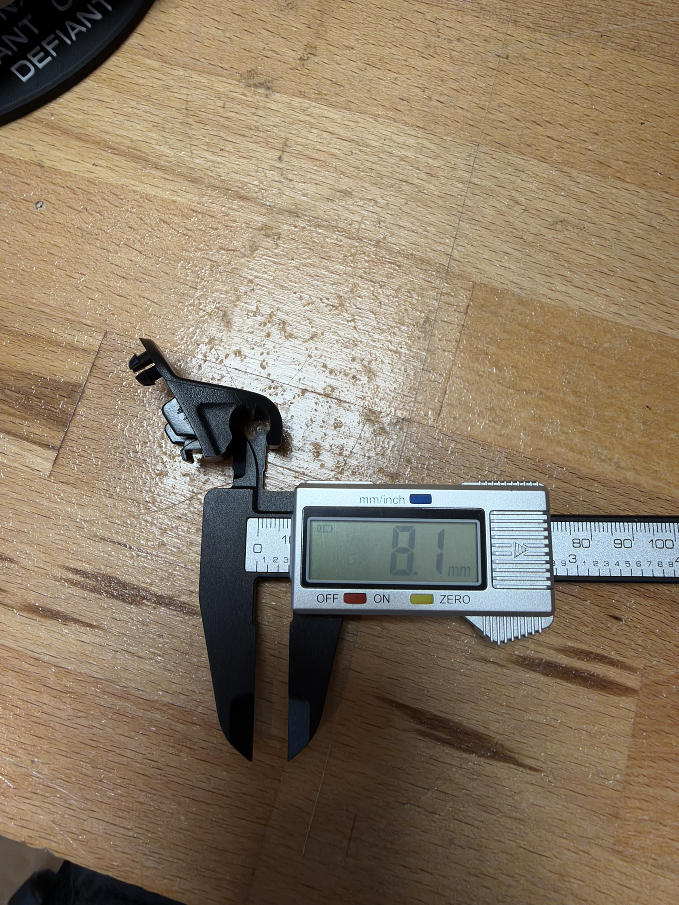
reference/measurements/09.jpg
