vingarzan/vw-touareg-760-867-899-tailgate-clip/reference/measurements/10.jpg

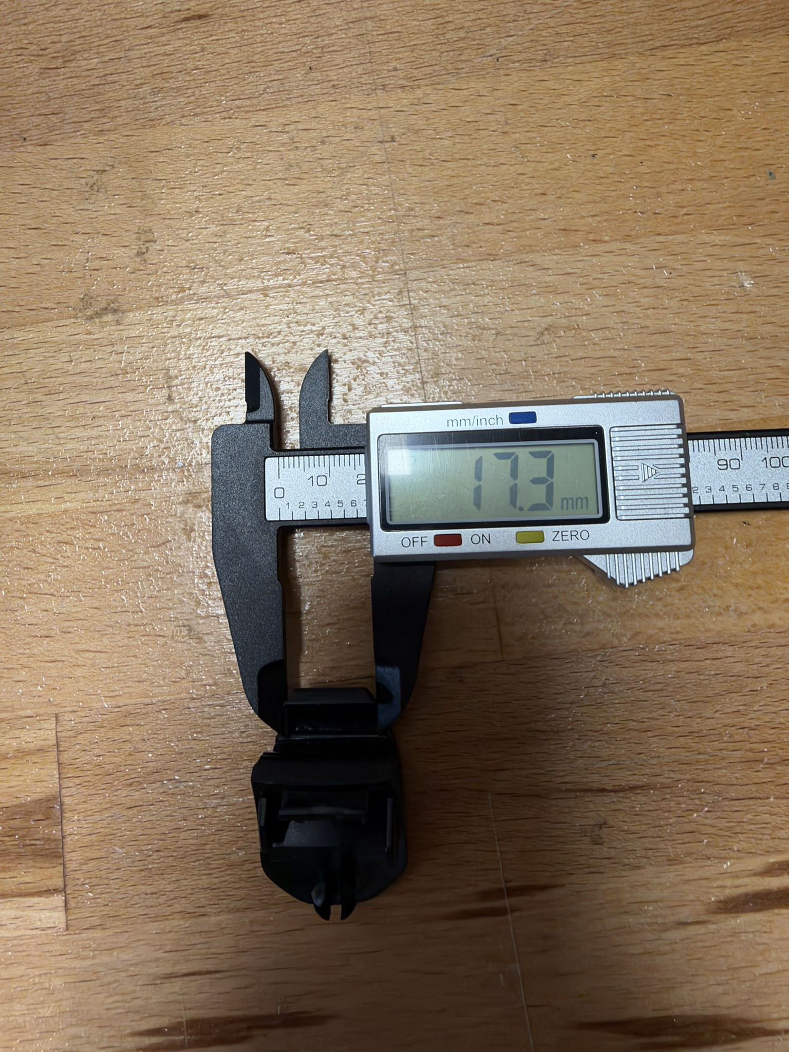
reference/measurements/10.jpg
