vingarzan/vw-touareg-760-867-899-tailgate-clip/reference/measurements/11.jpg

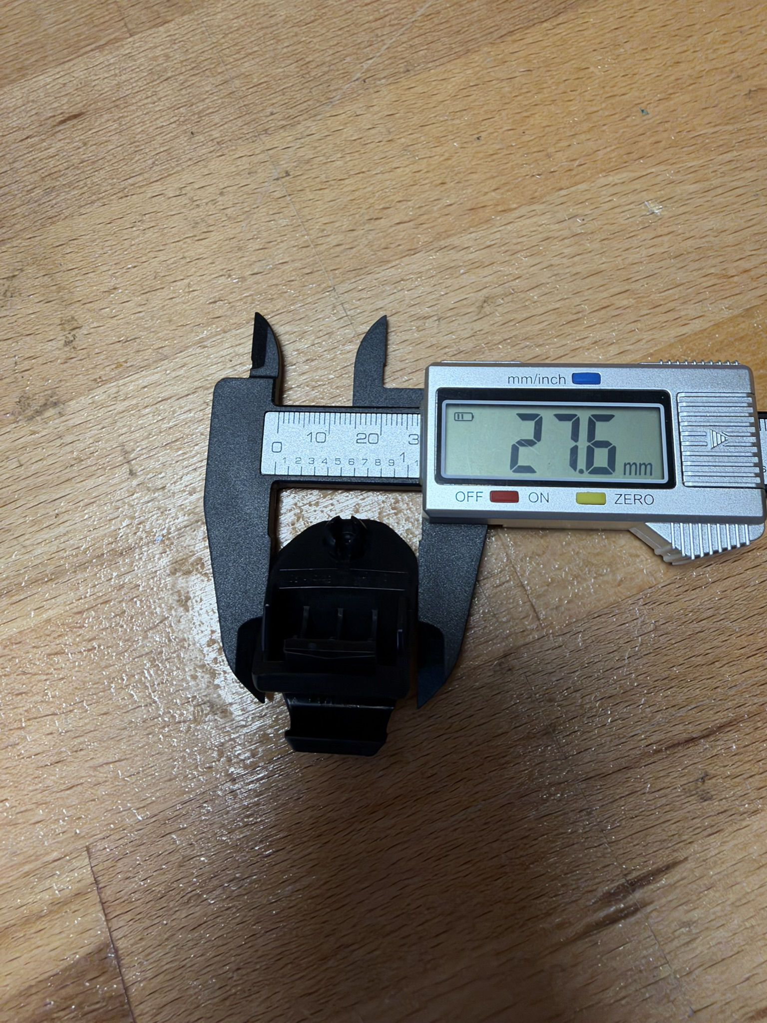
reference/measurements/11.jpg
