vingarzan/vw-touareg-760-867-899-tailgate-clip/reference/measurements/12.jpg

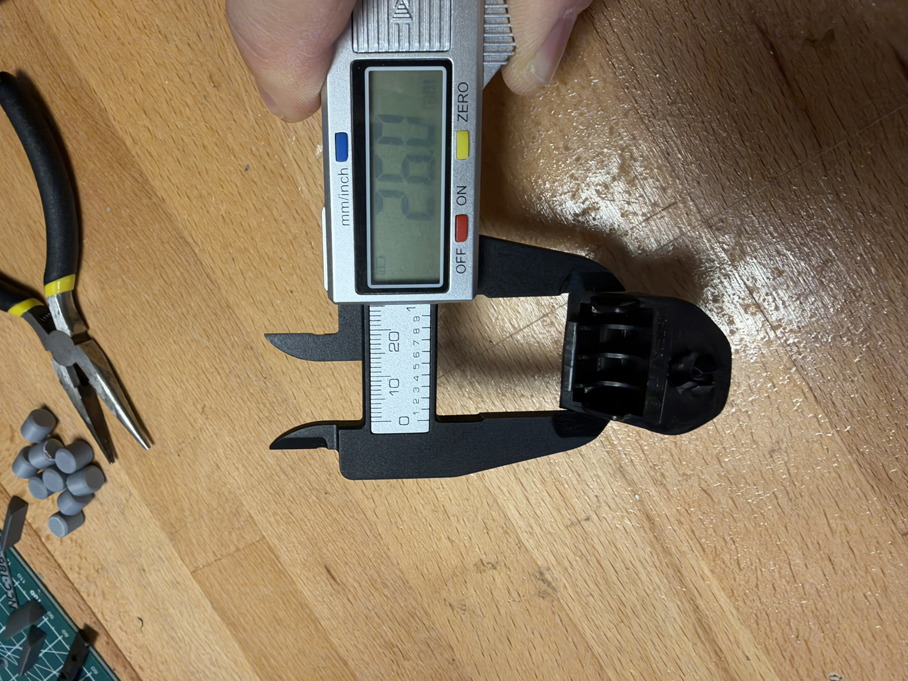
reference/measurements/12.jpg
