vingarzan/vw-touareg-760-867-899-tailgate-clip/reference/measurements/14.jpg

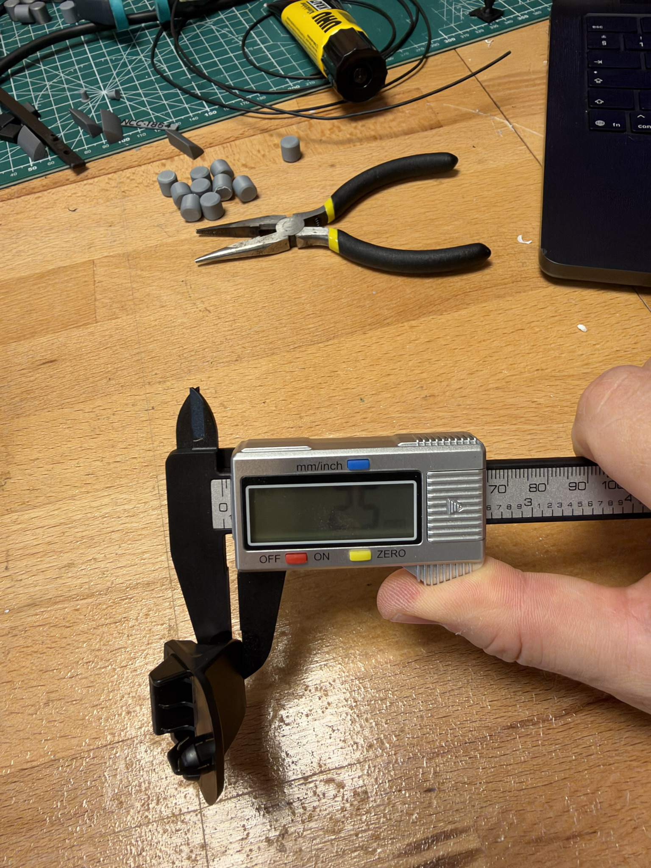
reference/measurements/14.jpg
