vingarzan/vw-touareg-760-867-899-tailgate-clip/reference/measurements/15.jpg

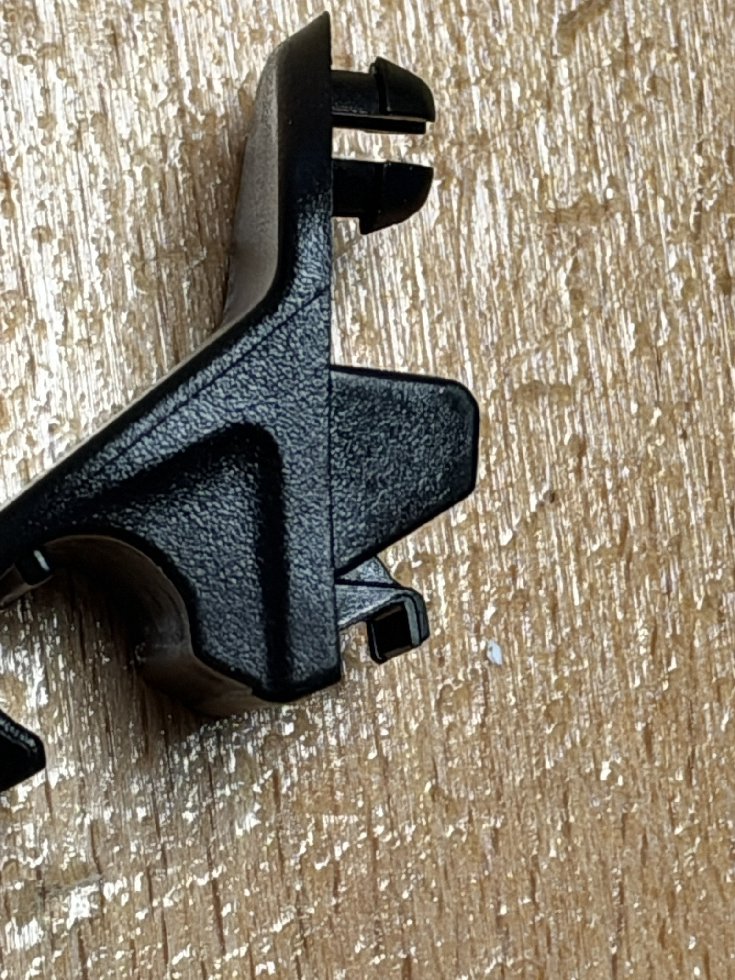
reference/measurements/15.jpg
