vingarzan/vw-touareg-760-867-899-tailgate-clip/reference/measurements/16.jpg

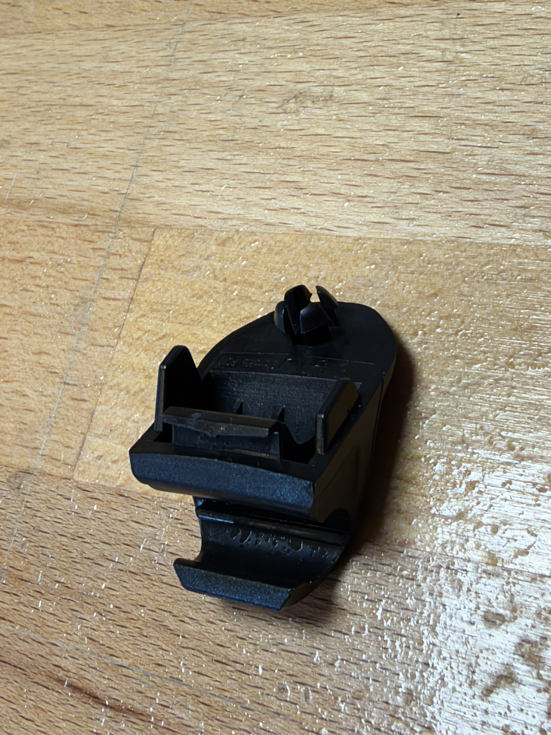
reference/measurements/16.jpg
