vingarzan/vw-touareg-760-867-899-tailgate-clip/reference/measurements/17.jpg

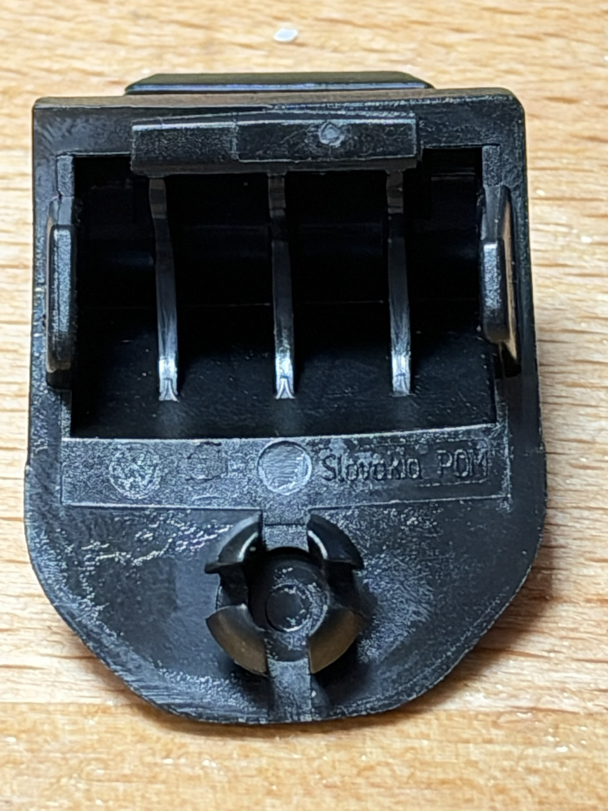
reference/measurements/17.jpg
