vingarzan/vw-touareg-760-867-899-tailgate-clip/reference/measurements/18.jpg

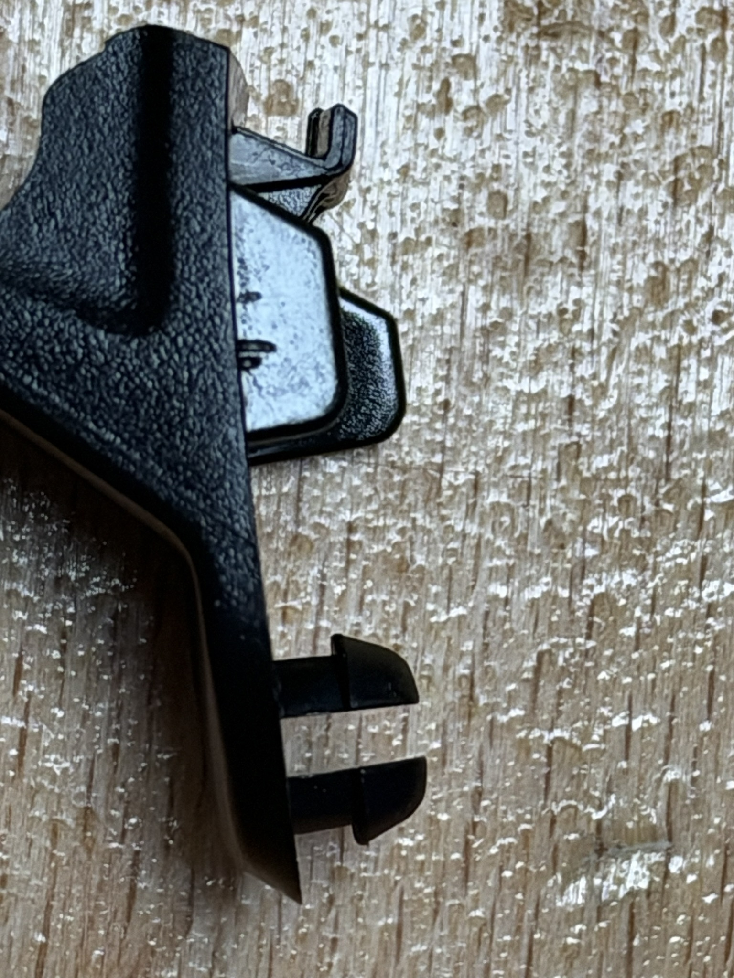
reference/measurements/18.jpg
