vingarzan/vw-touareg-760-867-899-tailgate-clip/reference/measurements/19.jpg

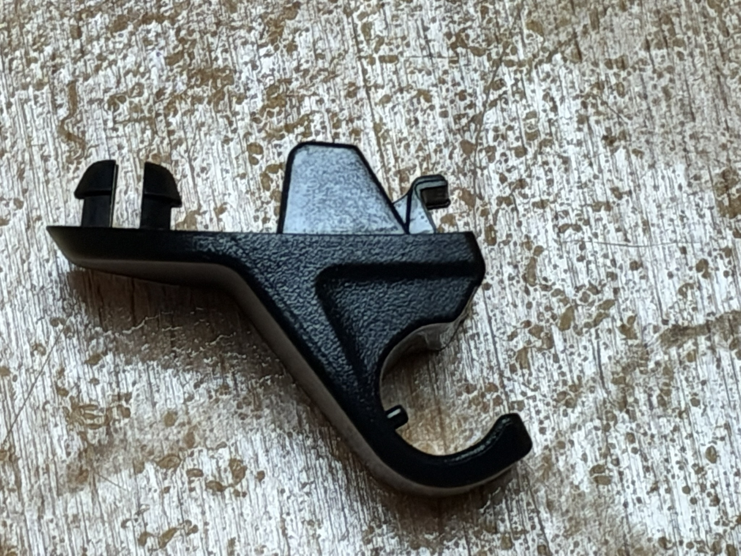
reference/measurements/19.jpg
