vingarzan/vw-touareg-760-867-899-tailgate-clip/reference/measurements/20.jpg

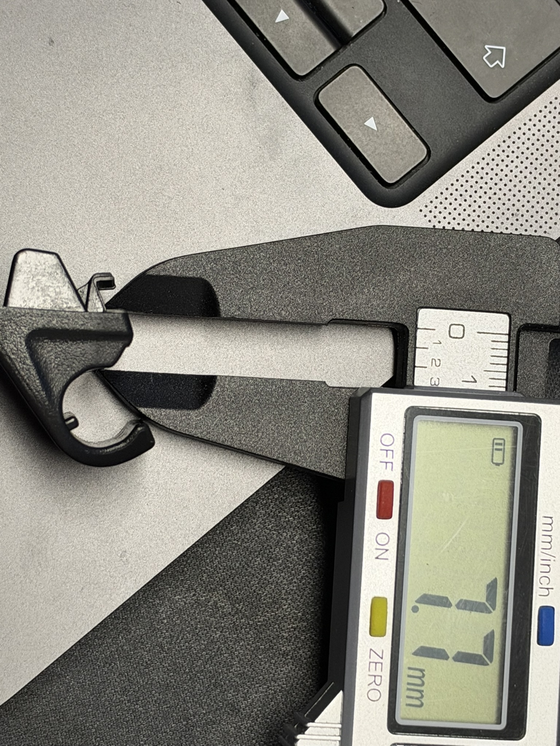
reference/measurements/20.jpg
