vingarzan/vw-touareg-760-867-899-tailgate-clip/reference/measurements/21.jpg

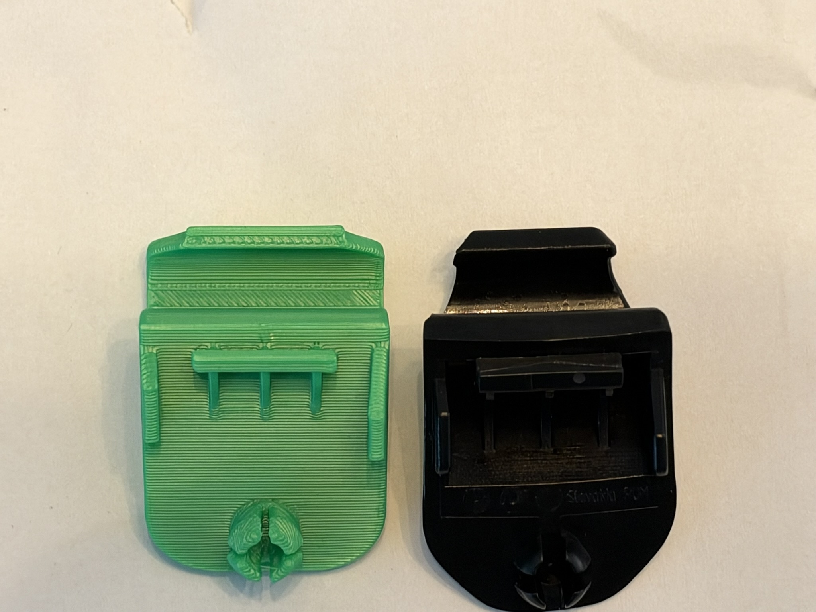
reference/measurements/21.jpg
