vingarzan/vw-touareg-760-867-899-tailgate-clip/reference/measurements/22.jpg

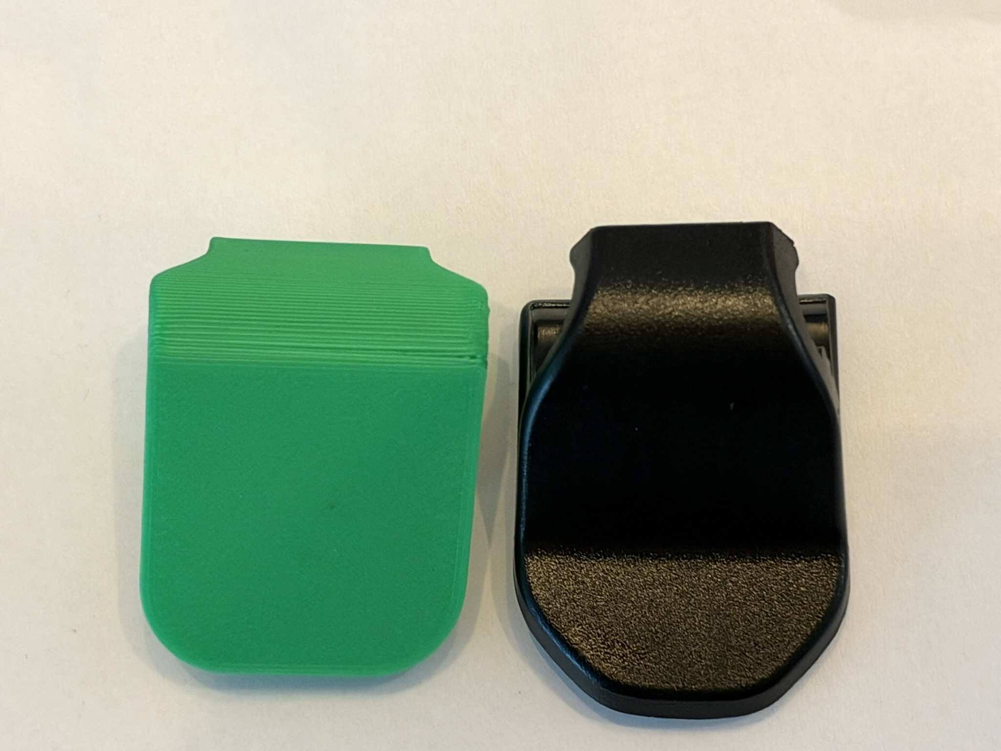
reference/measurements/22.jpg
