vingarzan/vw-touareg-760-867-899-tailgate-clip/reference/measurements/23.jpg

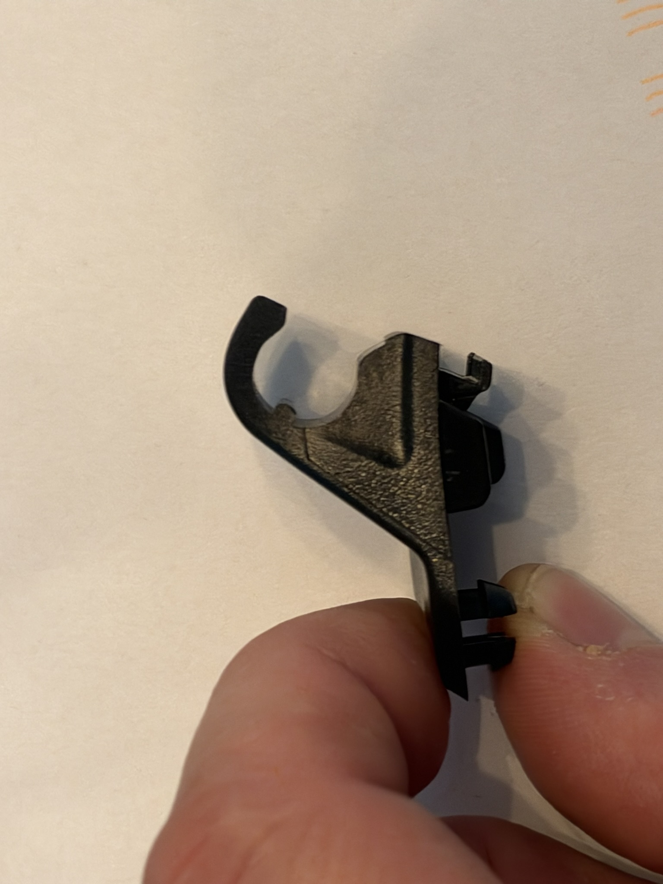
reference/measurements/23.jpg
