vingarzan/vw-touareg-760-867-899-tailgate-clip/(commit log)

2026-10-24 model: v01 reconstruct measured clip and add validated STL prototypes
2026-10-24 model: v03 add continuous latch wall and 9 mm longitudinal peg-to-fin gap
2026-10-24 model: v04 reopen hook mouth and add measured internal rib and 20 mm drop
2026-10-24 model: v05 correct tooth to 1.4 mm square opposite the opening
2026-10-24 model: v07 correct the hook inside diameter to 9.7 mm
2026-10-24 model: v08 add compact hook fit gauge ready to print on its flat side
2026-10-24 model: v09 make hook supports flush and reinforce peg leg roots
2026-10-24 model: v10 set measured 7.7 mm base-to-inside hook distance
2026-10-24 model: v13 add flat rear-support variant and print orientation
2026-10-24 model: v16 increase hook-side edge and inner-tip fillets to 0.4 mm
2026-10-24 model: v17 move retaining clip 2 mm and extend base length 4 mm
2026-10-24 model: snapshot v18 tapered draft STL before final edge treatment
2026-10-24 model: v19 fast draft with 24.5 mm outside fin-root span
2026-10-24 model: v21 contour-following recess and CAD fillets for flat support
2026-10-24 model: v23 add right-side fins swapped and shifted 6 mm toward peg
2026-10-24 model: v25 thicken peg legs internally and extend root reinforcement
2026-10-24 model: v28 add rounded internal fillets at peg leg roots
2026-10-24 model: v30 shorten lip 1.5 mm and raise all three rear supports
